Fedemayol024/Proyecto-Gen-Osc-STM32/hardware/ad9833_conexion.png

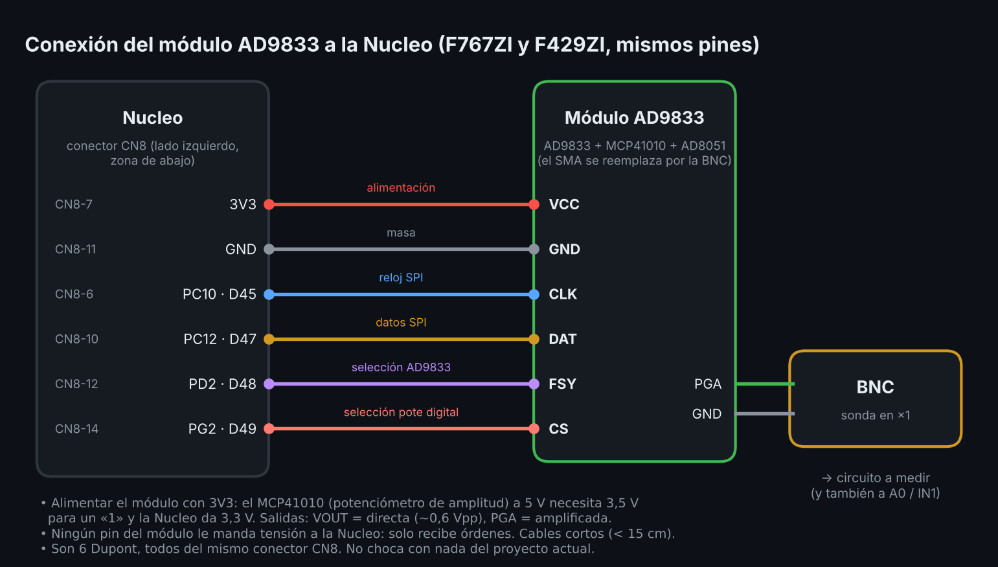
hardware/ad9833_conexion.png
