Fedemayol024/Proyecto-Gen-Osc-STM32/hardware/hoja1_salidas.png

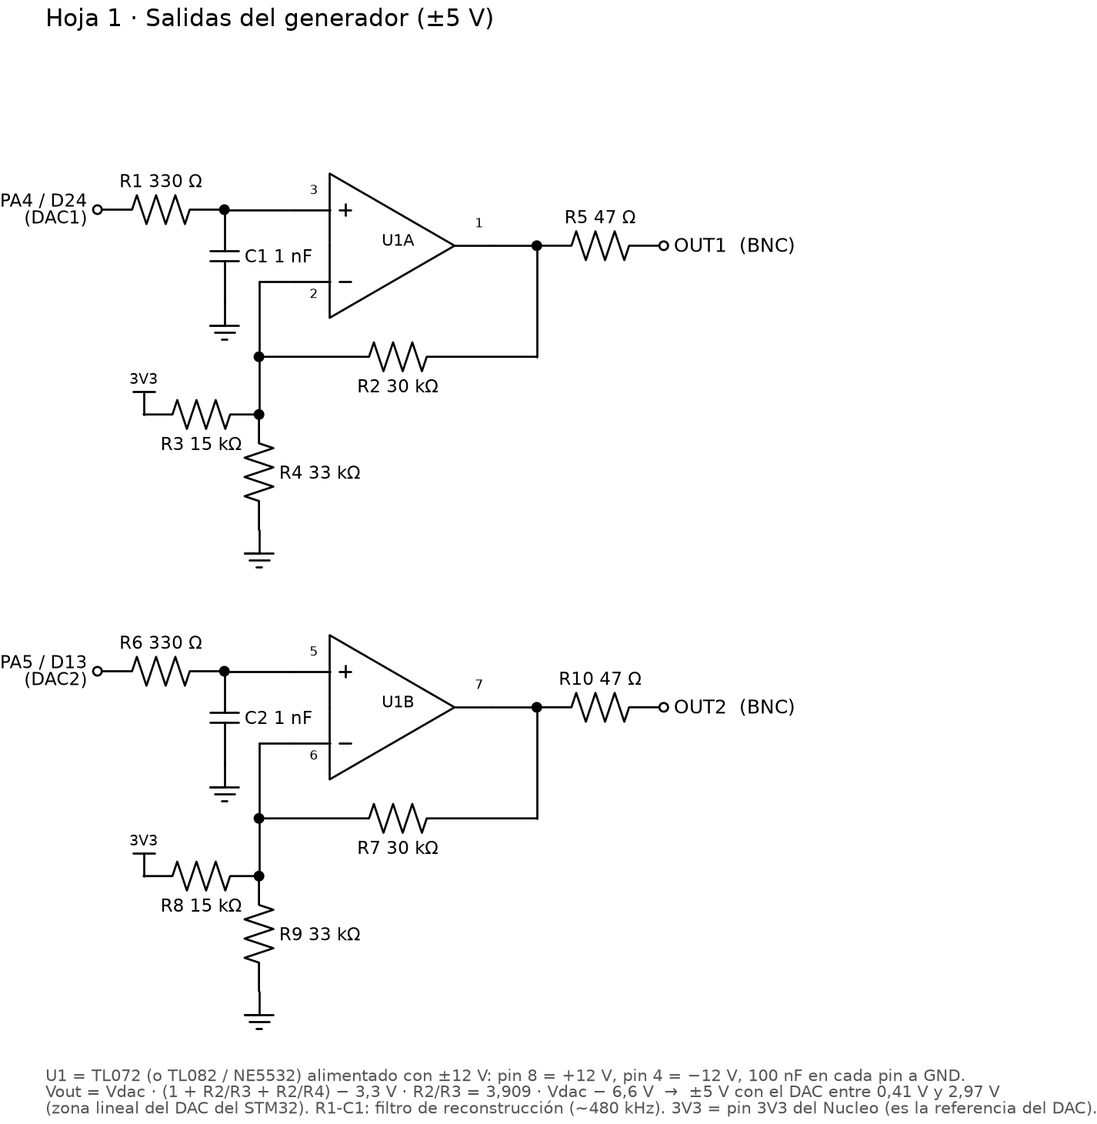
hardware/hoja1_salidas.png
