Fedemayol024/Proyecto-Gen-Osc-STM32/hardware/hoja2_entradas.png

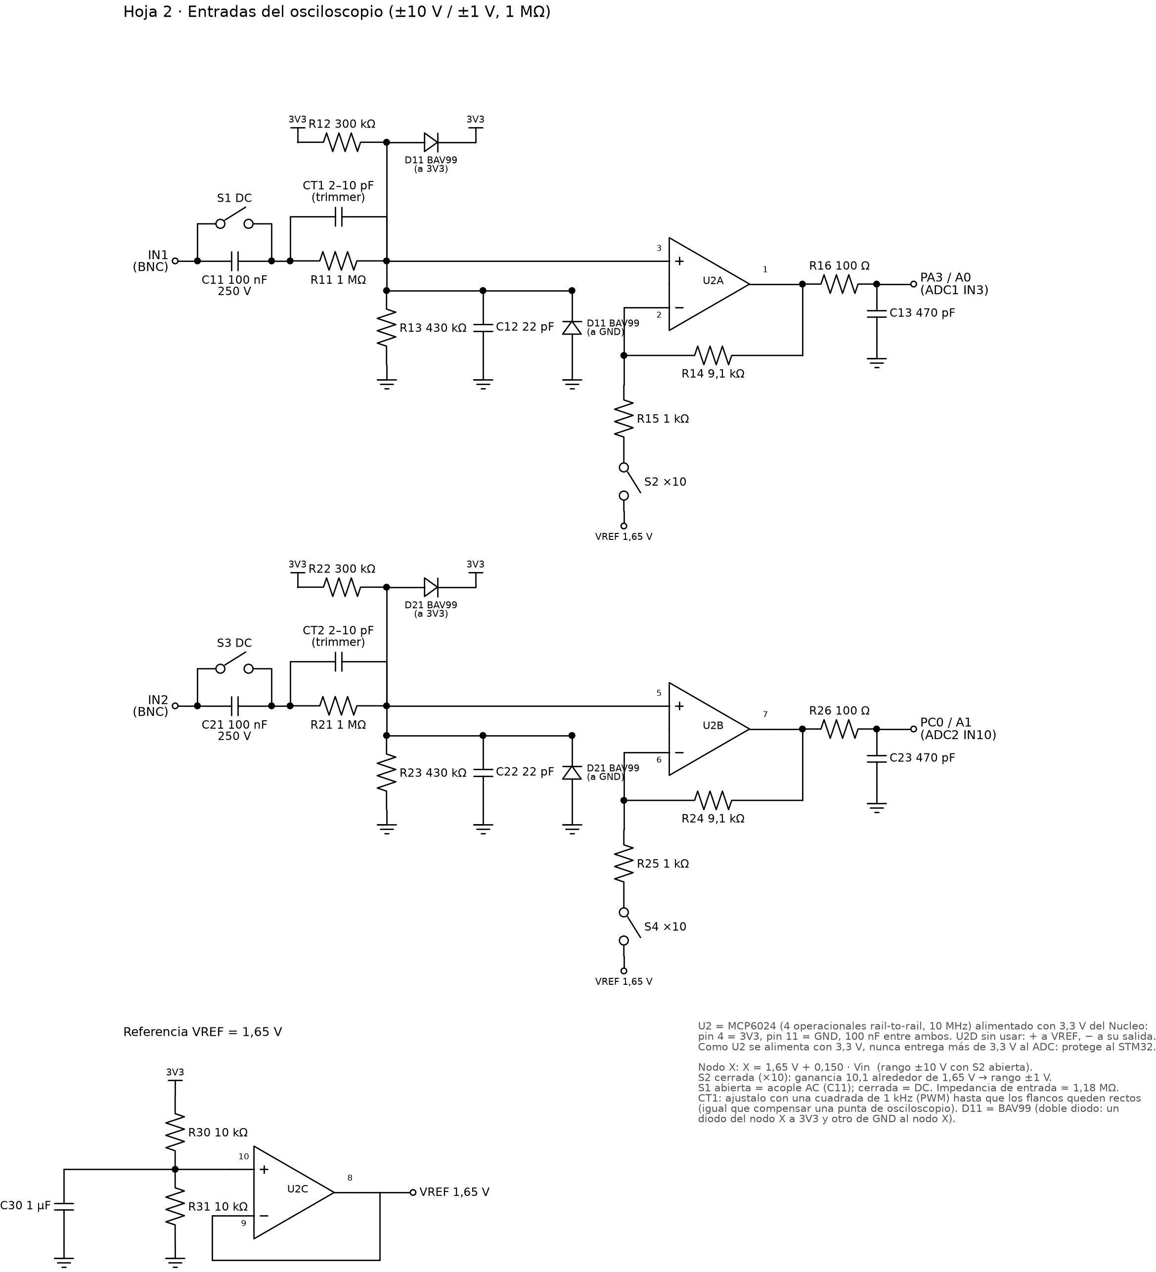
hardware/hoja2_entradas.png
