Fedemayol024/Proyecto-Gen-Osc-STM32/hardware/hoja3_frecuencimetro_pwm_alimentacion.png

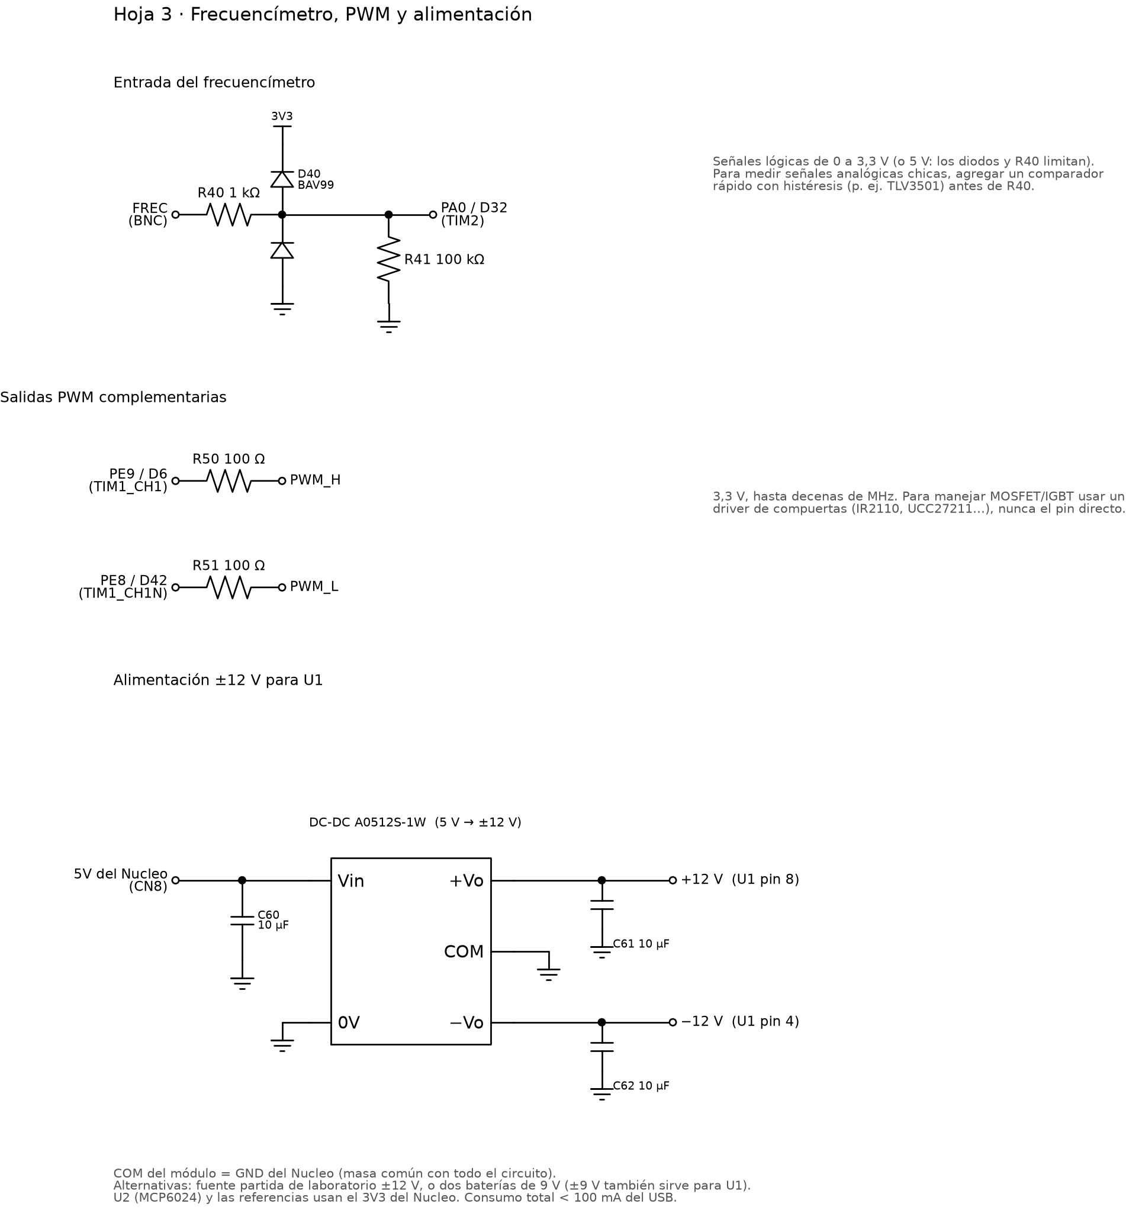
hardware/hoja3_frecuencimetro_pwm_alimentacion.png
