Fedemayol024/Proyecto-Gen-Osc-STM32/app/main.py

"""
Instrumento NUCLEO-F767ZI / NUCLEO-F429ZI - Osciloscopio + Generador + Bode + Herramientas
=========================================================================================
Al abrir se elige la placa (se puede recordar la elección y cambiarla después).
Ejecutar:   python main.py
Crear .exe: build_exe.bat
"""
from __future__ import annotations

import sys
import time
from pathlib import Path

from PySide6.QtCore import Qt, QTimer
from PySide6.QtGui import QActionGroup, QIcon
from PySide6.QtWidgets import (QApplication, QButtonGroup, QCheckBox, QComboBox, QDialog,
                               QHBoxLayout, QLabel, QMainWindow, QMenu, QMessageBox, QPushButton,
                               QStatusBar, QTabWidget, QToolButton, QVBoxLayout, QWidget)

import modelo as M
import widgets as W
from dispositivo import Dispositivo, listar_puertos
from tab_bode import TabBode
from tab_calibracion import TabCalibracion
from tab_generador import TabGenerador
from tab_herramientas import TabHerramientas
from tab_osciloscopio import TabOsciloscopio
from tab_placa import TabPlaca

# Versión de la app (MAYOR.MENOR.PARCHE). Mientras el MAYOR sea 0 es una beta: todavía
# se agregan funciones. El firmware usa el mismo número (INSTR_VERSION en instrumento.h);
# si cambia el MAYOR.MENOR, la app pide cargar el firmware nuevo.
VERSION = "0.9.0"
ETAPA = "beta"
VERSION_TEXTO = f"{VERSION} {ETAPA}".strip()


def misma_serie(a: str, b: str) -> bool:
    """True si dos versiones comparten MAYOR.MENOR (protocolo compatible)."""
    return a.split(".")[:2] == b.split(".")[:2]


def recurso(nombre: str) -> str:
    base = Path(getattr(sys, "_MEIPASS", Path(__file__).parent))
    return str(base / nombre)


class DialogoPlaca(QDialog):
    """Menú inicial: elegir con qué placa se va a trabajar."""

    def __init__(self, actual: str = M.PLACA_POR_DEFECTO, recordar: bool = False, parent=None):
        super().__init__(parent)
        self.setWindowTitle("Elegí la placa")
        W.tam(self, "setMinimumWidth", 520)
        lay = QVBoxLayout(self)
        lay.setContentsMargins(22, 20, 22, 18)
        lay.setSpacing(12)
        t = QLabel("¿Con qué placa vas a trabajar?")
        t.setStyleSheet(f"font-size: {W.pt(15)}pt; font-weight: 700; color: {W.TEXTO};")
        lay.addWidget(t)
        lay.addWidget(W.etiqueta_tenue("Cada placa tiene su propio firmware y guarda su propia "
                                       "calibración. Podés cambiarla después desde la barra de arriba."))
        self.grupo = QButtonGroup(self)
        self.grupo.setExclusive(True)
        self.botones = {}
        for clave, info in M.PLACAS.items():
            b = QPushButton(f"{info['nombre']}\n{info['detalle']}")
            b.setCheckable(True)
            W.tam(b, "setMinimumHeight", 64)
            b.setStyleSheet(f"QPushButton {{ text-align: left; padding: {W.px(10)}px {W.px(14)}px; font-size: {W.pt(11)}pt; }}")
            b.setChecked(clave == actual)
            b.clicked.connect(lambda _=False, c=clave: self._elegida(c))
            b.setProperty("clave", clave)
            self.grupo.addButton(b)
            self.botones[clave] = b
            lay.addWidget(b)
        self.recordar = QCheckBox("Recordar mi elección y no volver a preguntar")
        self.recordar.setChecked(recordar)
        lay.addWidget(self.recordar)
        fila = QHBoxLayout()
        fila.addStretch(1)
        fila.addWidget(W.boton("Cancelar", self.reject))
        self.btn_ok = W.boton("Continuar", self.accept, primario=True)
        fila.addWidget(self.btn_ok)
        lay.addLayout(fila)
        self._placa = actual if actual in M.PLACAS else M.PLACA_POR_DEFECTO
        self.botones[self._placa].setChecked(True)

    def _elegida(self, clave: str):
        self._placa = clave

    @property
    def placa(self) -> str:
        return self._placa


def elegir_placa(parent=None, forzar: bool = False) -> str | None:
    """Devuelve la placa elegida (y guarda la preferencia) o None si se canceló."""
    pref = M.cargar_preferencias()
    if not forzar and not pref["preguntar"]:
        return pref["placa"]
    dlg = DialogoPlaca(pref["placa"], recordar=not pref["preguntar"], parent=parent)
    if dlg.exec() != QDialog.Accepted:
        return None
    M.guardar_preferencias({"placa": dlg.placa, "preguntar": not dlg.recordar.isChecked()})
    return dlg.placa


class Ventana(QMainWindow):
    def __init__(self, placa: str = M.PLACA_POR_DEFECTO, auto_puerto: str | None = None):
        super().__init__()
        self.placa = placa if placa in M.PLACAS else M.PLACA_POR_DEFECTO
        self.version_app = VERSION_TEXTO
        nombre = M.nombre_placa(self.placa)
        self.setWindowTitle(f"Instrumento {nombre} · Osciloscopio y generador · v{VERSION_TEXTO}")
        self.resize(1360, 860)
        self.config = M.Config.cargar(self.placa)
        self.disp = Dispositivo()
        self.dueno_captura = None          # quién pidió la última captura
        self._esperado = None              # (n, pre) de la captura pedida
        self._mapa_puertos = {}

        central = QWidget()
        self.setCentralWidget(central)
        raiz = QVBoxLayout(central)
        raiz.setContentsMargins(8, 8, 8, 4)

        # barra de conexión
        barra = QHBoxLayout()
        titulo = QLabel("◉  Instrumento")
        titulo.setObjectName("titulo")
        barra.addWidget(titulo)
        self.btn_placa = W.boton(f"{nombre}  ▾", self._menu_placa)
        self.btn_placa.setToolTip("Cambiar de placa")
        barra.addWidget(self.btn_placa)
        barra.addSpacing(16)
        self.combo_puertos = QComboBox()
        W.tam(self.combo_puertos, "setMinimumWidth", 320)
        barra.addWidget(self.combo_puertos)
        barra.addWidget(W.boton("↻", self.actualizar_puertos))
        self.btn_con = W.boton("Conectar", self.alternar_conexion, primario=True)
        barra.addWidget(self.btn_con)
        # el texto de conexión es largo: se recorta con «…» si no entra (antes ensanchaba
        # la ventana más allá de la pantalla en las notebooks)
        self.lbl_con = W.EtiquetaRecortable("● Desconectado")
        self.lbl_con.setStyleSheet(f"color: {W.TENUE};")
        barra.addWidget(self.lbl_con, 1)
        # opciones gráficas (ruedita): resolución de la interfaz
        self.btn_opciones = QToolButton()
        self.btn_opciones.setText("⚙")
        self.btn_opciones.setObjectName("ruedita")
        self.btn_opciones.setToolTip("Opciones gráficas: resolución de la interfaz")
        self.btn_opciones.setPopupMode(QToolButton.InstantPopup)
        self.menu_opciones = QMenu(self)
        self.menu_opciones.aboutToShow.connect(self._armar_menu_opciones)
        self.btn_opciones.setMenu(self.menu_opciones)
        barra.addWidget(self.btn_opciones)
        raiz.addLayout(barra)
        W.al_cambiar_escala(self._escala_cambiada)

        self._t_guardar = QTimer(self)
        self._t_guardar.setSingleShot(True)
        self._t_guardar.timeout.connect(self.guardar_config)

        self.tabs = QTabWidget()
        raiz.addWidget(self.tabs, 1)
        self.tab_gen = TabGenerador(self)
        self.tab_osc = TabOsciloscopio(self)
        self.tab_bode = TabBode(self)
        self.tab_herr = TabHerramientas(self)
        self.tab_cal = TabCalibracion(self)
        self.tab_placa = TabPlaca(self)
        self.tabs.addTab(self.tab_osc, "Osciloscopio")
        self.tabs.addTab(self.tab_gen, "Generador")
        self.tabs.addTab(self.tab_bode, "Bode")
        self.tabs.addTab(self.tab_herr, "Frecuencímetro y PWM")
        self.tabs.addTab(self.tab_cal, "Calibración")
        self.tabs.addTab(self.tab_placa, "Placa")

        self.setStatusBar(QStatusBar())
        self.estado(f"Versión {VERSION_TEXTO}. Conectá el USB USER (CN13) del Nucleo y tocá Conectar.")
        self._escala_cambiada()

        self.disp.conectado.connect(self._al_conectar)
        self.disp.desconectado.connect(self._perdida_conexion)
        self.disp.error.connect(self._error_conexion)
        # Reconexión automática: si la placa se reinicia (watchdog, RESET, cable flojo) el puerto
        # USB desaparece y vuelve a aparecer; la app lo busca un rato y se reconecta sola.
        self._reconexion = None
        self._t_recon = QTimer(self)
        self._t_recon.timeout.connect(self._intentar_reconexion)
        self.disp.linea.connect(self._al_linea)
        self.disp.datos.connect(self._al_datos)

        self.actualizar_puertos()
        if auto_puerto:
            for et, dev in self._mapa_puertos.items():
                if dev == auto_puerto:
                    self.combo_puertos.setCurrentText(et)
                    QTimer.singleShot(400, self.alternar_conexion)
                    break

    # -------------------------------------------------------------- opciones gráficas
    def resolucion_pantalla(self) -> tuple[int, int]:
        """Resolución real (píxeles físicos) de la pantalla donde está la ventana."""
        pantalla = self.screen() or QApplication.primaryScreen()
        return resolucion_de(pantalla)

    def _armar_menu_opciones(self):
        m = self.menu_opciones
        m.clear()
        pant = self.resolucion_pantalla()
        elegida = M.resolucion_guardada()
        titulo = m.addAction("Resolución de la interfaz")
        titulo.setEnabled(False)
        grupo = QActionGroup(m)
        grupo.setExclusive(True)

        def opcion(texto, res):
            a = m.addAction(texto)
            a.setCheckable(True)
            a.setChecked(res == elegida)
            a.triggered.connect(lambda _=False, r=res: self.elegir_resolucion(r))
            grupo.addAction(a)
            return a

        opcion(f"Automática · la de la pantalla ({M.texto_resolucion(pant)})", None)
        m.addSeparator()
        for res in M.RESOLUCIONES:
            e = M.escala_para(res, pant)
            if not (M.ESCALA_MIN <= min(pant[0] / res[0], pant[1] / res[1]) <= M.ESCALA_MAX):
                continue
            if res == pant:
                nota = "igual a la pantalla"
            elif e > 1:
                nota = f"todo más grande · {round(e * 100)} %"
            else:
                nota = f"entra más · {round(e * 100)} %"
            opcion(f"{M.texto_resolucion(res)}   ({nota})", res)
        m.addSeparator()
        a = m.addAction("Ajustar la ventana a la pantalla")
        a.triggered.connect(lambda: self.ajustar_a_pantalla(forzar=True))

    def elegir_resolucion(self, res: tuple[int, int] | None):
        M.guardar_resolucion(res)
        escala = M.escala_para(res, self.resolucion_pantalla())
        if abs(escala - W.ESCALA) > 1e-6:
            QApplication.setOverrideCursor(Qt.WaitCursor)
            try:
                W.aplicar_escala(QApplication.instance(), escala)
            finally:
                QApplication.restoreOverrideCursor()
        self.ajustar_a_pantalla()
        QTimer.singleShot(0, self.ajustar_a_pantalla)     # por si el layout termina de crecer después
        nombre = M.texto_resolucion(res) if res else "automática (la de la pantalla)"
        self.estado(f"Resolución de la interfaz: {nombre} · escala {round(escala * 100)} %.", W.OK)

    def ajustar_a_pantalla(self, forzar: bool = False):
        """Que la ventana entre en la pantalla: si lo mínimo que necesita no entra, se
        maximiza (y se avisa); si sobra lugar, se respeta el tamaño que tenga."""
        if self.isFullScreen():
            return
        pantalla = self.screen() or QApplication.primaryScreen()
        libre = pantalla.availableGeometry()
        minimo = self.minimumSizeHint()
        if minimo.width() > libre.width() or minimo.height() > libre.height():
            self.showMaximized()
            self.estado("La interfaz no entra en esta pantalla: elegí una resolución más grande "
                        "en ⚙ (Opciones gráficas).", W.ALERTA)
            return
        if self.isMaximized() and not forzar:
            return
        ancho = min(max(self.width(), minimo.width()), libre.width())
        alto = min(max(self.height(), minimo.height()), libre.height())
        if forzar:
            self.showNormal()
            ancho, alto = libre.width(), libre.height()
        # El borde de la ventana (barra de título) suma al tamaño: se calcula con el
        # tamaño NUEVO, no con el que tenía antes de agrandarse.
        g = self.frameGeometry()
        borde_x, borde_y = g.width() - self.width(), g.height() - self.height()
        ancho = min(ancho, libre.width() - borde_x)
        alto = min(alto, libre.height() - borde_y)
        self.resize(ancho, alto)
        x = min(max(g.x(), libre.x()), libre.right() + 1 - (ancho + borde_x))
        y = min(max(g.y(), libre.y()), libre.bottom() + 1 - (alto + borde_y))
        self.move(max(x, libre.x()), max(y, libre.y()))

    def _escala_cambiada(self):
        W.escalar_graficos(self)
        for w in self.findChildren(QWidget):
            w.update()

    # -------------------------------------------------------------- placa
    def _menu_placa(self):
        nueva = elegir_placa(self, forzar=True)
        if nueva and nueva != self.placa:
            self.cambiar_placa(nueva)

    def cambiar_placa(self, placa: str, puerto: str | None = None):
        """Reabre la ventana con la configuración y calibración de otra placa."""
        pref = M.cargar_preferencias()
        pref["placa"] = placa
        M.guardar_preferencias(pref)
        if self.disp.esta_conectado:
            self.disp.enviar("CAPX")
            self.disp.cerrar()
        nueva = Ventana(placa, auto_puerto=puerto)
        nueva.resize(self.size())
        nueva.move(self.pos())
        app = QApplication.instance()
        app._ventana = nueva
        nueva.show()
        self.setAttribute(Qt.WA_DeleteOnClose)       # que la ventana vieja no quede viva
        self.close()

    # -------------------------------------------------------------- estado
    def estado(self, texto: str, color: str = W.TENUE):
        self.statusBar().setStyleSheet(f"color: {color};")
        self.statusBar().showMessage(texto)

    def guardar_config_pronto(self):
        self._t_guardar.start(1500)

    def guardar_config(self):
        if not hasattr(self, "tab_cal"):
            return
        self.config.gen = self.tab_gen.estado_config()
        self.config.osc = self.tab_osc.estado_config()
        h = self.tab_herr.estado_config()
        h["bode"] = self.tab_bode.estado_config()
        self.config.herramientas = h
        self.config.guardar()

    # -------------------------------------------------------------- conexión
    def actualizar_puertos(self):
        puertos = listar_puertos()
        self._mapa_puertos = {et: dev for dev, et in puertos}
        self.combo_puertos.clear()
        if not puertos:
            self.combo_puertos.addItem("No hay puertos")
            return
        self.combo_puertos.addItems([et for _, et in puertos])
        for dev, et in puertos:
            if dev == self.config.puerto:
                self.combo_puertos.setCurrentText(et)
                break

    # -------------------------------------------------------------- reconexión
    RECONEXION_S = 20.0

    def _perdida_conexion(self, motivo: str):
        puerto = self._reconexion["puerto"] if self._reconexion else self.config.puerto
        self._al_desconectar(f"{motivo} Reintentando conectar…", W.ALERTA)
        if puerto:
            self._reconexion = {"puerto": puerto, "hasta": time.monotonic() + self.RECONEXION_S,
                                "intentando": False}
            self.btn_con.setText("Cancelar")
            self.lbl_con.setText(f"● Reconectando con {puerto}…")
            self.lbl_con.setStyleSheet(f"color: {W.ALERTA};")
            self._t_recon.start(1000)

    def _error_conexion(self, motivo: str):
        if self._reconexion:                 # durante la reconexión los fallos son esperables
            self._reconexion["intentando"] = False
            return
        self._al_desconectar(motivo, W.ERROR)

    def _cancelar_reconexion(self):
        self._t_recon.stop()
        self._reconexion = None

    def _intentar_reconexion(self):
        r = self._reconexion
        if not r:
            self._t_recon.stop()
            return
        if self.disp.esta_conectado or r["intentando"]:
            return
        if time.monotonic() > r["hasta"]:
            self._cancelar_reconexion()
            self._al_desconectar("No se pudo reconectar con la placa. Revisá el cable USB USER y "
                                 "tocá Conectar.", W.ERROR)
            return
        if r["puerto"] in [dev for dev, _ in listar_puertos()]:
            r["intentando"] = True
            self.disp.abrir(r["puerto"])

    def alternar_conexion(self):
        if self._reconexion:                 # el botón dice «Cancelar»
            self._cancelar_reconexion()
            self.disp.cerrar()
            self._al_desconectar("Reconexión cancelada.", W.TENUE)
            return
        if self.disp.esta_conectado:
            self.disp.cerrar()
            self._al_desconectar("Desconectado.", W.TENUE)
            return
        puerto = self._mapa_puertos.get(self.combo_puertos.currentText())
        if not puerto:
            self.estado("Elegí un puerto (conectá el USB USER del Nucleo y tocá ↻).", W.ALERTA)
            return
        self.btn_con.setEnabled(False)
        self.btn_con.setText("Conectando…")
        self.lbl_con.setText(f"● Buscando el instrumento en {puerto}…")
        self.lbl_con.setStyleSheet(f"color: {W.ALERTA};")
        self.disp.abrir(puerto)

    def _al_conectar(self, version: str):
        detectada = self.disp.placa
        if detectada and detectada != self.placa:
            puerto = self.disp.puerto
            self.disp.cerrar()
            self._al_desconectar(f"La placa conectada es {M.nombre_placa(detectada)}, no "
                                 f"{M.nombre_placa(self.placa)}.", W.ALERTA)
            if detectada in M.PLACAS:
                r = QMessageBox.question(
                    self, "Otra placa",
                    f"La placa conectada es una {M.nombre_placa(detectada)}, pero la app está "
                    f"configurada para {M.nombre_placa(self.placa)}.\n\n"
                    f"¿Cambiar a {M.nombre_placa(detectada)} y conectar?")
                if r == QMessageBox.Yes:
                    self.cambiar_placa(detectada, puerto)
            return
        reconectado = self._reconexion is not None
        self._cancelar_reconexion()
        self.config.puerto = self.disp.puerto
        self.btn_con.setEnabled(True)
        self.btn_con.setText("Desconectar")
        info = self.disp.info
        self.lbl_con.setText(f"● Conectado · {self.disp.puerto} · {M.nombre_placa(self.placa)} · firmware v{version} · "
                             f"generador {M.si(info.get('gen_fs', 0), 'S/s', 3)} · "
                             f"osciloscopio hasta {M.si(info.get('osc_fsmax', 0), 'S/s', 3)}")
        self.lbl_con.setStyleSheet(f"color: {W.OK};")
        self.tab_gen.reenviar_todo()
        self.tab_osc.al_conectar()
        self.tab_placa.al_conectar()
        self.guardar_config_pronto()
        if not misma_serie(version, VERSION):
            self.estado(f"El firmware de la placa es v{version} y la app es v{VERSION}: cargá el "
                        "firmware de esta versión para que todo funcione bien.", W.ALERTA)
        elif info.get("reinicio") == "watchdog":
            self.estado("Atención: la placa se reinició sola porque el firmware se había colgado "
                        "(watchdog). Se volvió a enviar la configuración.", W.ALERTA)
        elif reconectado:
            self.estado("Reconectado automáticamente. Se volvió a enviar la configuración.", W.OK)
        else:
            self.estado("Instrumento conectado.", W.OK)

    def _al_desconectar(self, motivo: str, color: str):
        self.btn_con.setEnabled(True)
        self.btn_con.setText("Conectar")
        self.lbl_con.setText("● Desconectado")
        self.lbl_con.setStyleSheet(f"color: {W.TENUE};")
        self.tab_osc.al_desconectar()
        self.tab_herr.al_desconectar()
        self.tab_placa.al_desconectar()
        if self.tab_bode.activo:
            self.tab_bode.activo = False
            self.tab_bode.btn.setText("Iniciar barrido")
        self.estado(motivo, color)

    def _al_linea(self, linea: str):
        if linea.startswith("ERR") and not linea.startswith("ERR GTBL"):
            self.estado(f"La placa respondió: {linea}", W.ERROR)
        self.tab_gen.al_linea(linea)
        self.tab_herr.al_linea(linea)

    def pedir_captura(self, dueno: str, n: int, pre: int, fs: float, fuente: int = 0,
                      nivel: int = 2048, flanco: int = 0, hist: int = 20):
        """Pide una captura y recuerda quién la pidió (los datos que no
        coinciden con el último pedido se descartan)."""
        self.dueno_captura = dueno
        self._esperado = (int(n), int(pre))
        self.disp.enviar(f"CAP {int(n)} {int(pre)} {fs:.4f} {fuente} {nivel} {flanco} {hist}")

    def cancelar_captura(self):
        self._esperado = None
        if self.disp.esta_conectado:
            self.disp.enviar("CAPX")

    def _al_datos(self, d: dict):
        if self._esperado is None or (d["n"], d["pre"]) != self._esperado:
            return
        self._esperado = None
        dueno = self.dueno_captura
        if dueno == "bode":
            self.tab_bode.al_recibir(d)
        elif dueno == "cal":
            self.tab_cal.al_recibir(d)
        elif dueno == "dds":
            self.tab_gen.dds.al_captura(d)
        else:
            self.tab_osc.al_recibir(d)

    def closeEvent(self, e):
        self.tab_osc.fosforo.timer.stop()
        if self.tab_osc.dlg_fft is not None:
            self.tab_osc.dlg_fft.close()
        self.guardar_config()
        if self.disp.esta_conectado:
            self.disp.enviar("CAPX")
        self.disp.cerrar()
        super().closeEvent(e)


def resolucion_de(pantalla) -> tuple[int, int]:
    """Píxeles físicos de una pantalla (Qt da medidas lógicas, ya divididas por el
    escalado de Windows: 1920×1080 al 150 % aparece como 1280×720)."""
    if pantalla is None:
        return (1920, 1080)
    g, r = pantalla.geometry(), pantalla.devicePixelRatio()
    return (round(g.width() * r), round(g.height() * r))


def main():
    app = QApplication(sys.argv)
    W.ESCALA = M.escala_para(M.resolucion_guardada(), resolucion_de(app.primaryScreen()))
    app.setStyleSheet(W.estilo())
    ico = recurso("icono.ico")
    if Path(ico).exists():
        app.setWindowIcon(QIcon(ico))
    placa = elegir_placa()
    if placa is None:
        return
    app._ventana = Ventana(placa)
    app._ventana.show()
    QTimer.singleShot(0, app._ventana.ajustar_a_pantalla)
    sys.exit(app.exec())


if __name__ == "__main__":
    main()
