Fedemayol024/Proyecto-Gen-Osc-STM32/app/modelo.py

"""
Modelo del instrumento: calibraciones, conversión tensión <-> código y
armado de las tablas de forma de onda. No depende de la interfaz.
"""
from __future__ import annotations

import json
import math
import os
from dataclasses import dataclass, asdict, field
from pathlib import Path

import numpy as np

TABLA_N = 4096           # puntos por período en el generador
DAC_MAX = 4095
ADC_MAX = 4095
VREF = 3.3


# ---------------------------------------------------------------------------
# Recta código <-> tensión (sirve para el DAC y para el ADC)
# ---------------------------------------------------------------------------
@dataclass
class Recta:
    codigo_a: float
    volt_a: float
    codigo_b: float
    volt_b: float

    @property
    def pendiente(self) -> float:
        return (self.volt_b - self.volt_a) / (self.codigo_b - self.codigo_a)

    def volt(self, codigo):
        return self.volt_a + (np.asarray(codigo, dtype=float) - self.codigo_a) * self.pendiente

    def codigo(self, volt):
        return self.codigo_a + (np.asarray(volt, dtype=float) - self.volt_a) / self.pendiente

    def valida(self) -> bool:
        try:
            return (self.codigo_a != self.codigo_b and abs(self.pendiente) > 1e-9
                    and all(math.isfinite(v) for v in asdict(self).values()))
        except (ZeroDivisionError, TypeError):
            return False

    @staticmethod
    def desde_dict(d) -> "Recta | None":
        try:
            r = Recta(float(d["codigo_a"]), float(d["volt_a"]), float(d["codigo_b"]), float(d["volt_b"]))
            return r if r.valida() else None
        except (KeyError, TypeError, ValueError):
            return None


def _recta_lineal(f, c0=0.0, c1=4095.0) -> Recta:
    return Recta(c0, float(f(c0)), c1, float(f(c1)))


# ---------------------------------------------------------------------------
# Salidas del generador
# ---------------------------------------------------------------------------
# Etapa de salida de la placa (igual topología que el proyecto ESP32):
#   Vout = Vdac (1 + Rf/Rref + Rf/Rgnd) - 3,3 V · Rf/Rref
RF_OUT, RREF_OUT, RGND_OUT = 30e3, 15e3, 33e3
G_OUT = 1 + RF_OUT / RREF_OUT + RF_OUT / RGND_OUT
OFF_OUT = VREF * RF_OUT / RREF_OUT

# Zona lineal del DAC del STM32 con el buffer de salida activado
DAC_V_MIN, DAC_V_MAX = 0.2, 3.1


@dataclass(frozen=True)
class ModoSalida:
    clave: str
    nombre: str
    vmin: float
    vmax: float
    diseno: Recta


def _vdac(c):
    return VREF * np.asarray(c, dtype=float) / DAC_MAX


MODOS_SALIDA = {
    "PLACA": ModoSalida("PLACA", "Placa ±5 V", -5.0, 5.0,
                        _recta_lineal(lambda c: G_OUT * _vdac(c) - OFF_OUT)),
    "DIRECTO": ModoSalida("DIRECTO", "Pin directo (0,2–3,1 V)", DAC_V_MIN, DAC_V_MAX,
                          _recta_lineal(_vdac)),
}

# ---------------------------------------------------------------------------
# Entradas del osciloscopio
# ---------------------------------------------------------------------------
# Atenuador de entrada: X = 1,65 V + K·Vin   (R1 = 1 MΩ, R2 = 300 kΩ a 3,3 V,
# R3 = 430 kΩ a GND) y luego ganancia 1 o 10,1 alrededor de 1,65 V.
R1_IN, R2_IN, R3_IN = 1e6, 300e3, 430e3
_G = 1 / R1_IN + 1 / R2_IN + 1 / R3_IN
K_IN = (1 / R1_IN) / _G
BIAS_IN = (VREF / R2_IN) / _G
G_ALTA = 1 + 9.1e3 / 1e3
VMED = 1.65


def _vadc(c):
    return VREF * np.asarray(c, dtype=float) / ADC_MAX


@dataclass(frozen=True)
class ModoEntrada:
    clave: str
    nombre: str
    rango: float          # ± tensión de entrada aproximada (para la interfaz)
    diseno: Recta


def _vin_rango(ganancia):
    # Vadc = VMED + g·(BIAS_IN + K·Vin - VMED)  ->  Vin
    return lambda c: ((_vadc(c) - VMED) / ganancia + VMED - BIAS_IN) / K_IN


MODOS_ENTRADA = {
    "ALTO": ModoEntrada("ALTO", "Placa ±10 V", 10.0, _recta_lineal(_vin_rango(1.0))),
    "BAJO": ModoEntrada("BAJO", "Placa ±1 V (×10)", 1.0, _recta_lineal(_vin_rango(G_ALTA))),
    "DIRECTO": ModoEntrada("DIRECTO", "Pin directo (0–3,3 V)", 3.3, _recta_lineal(_vadc)),
}

# ---------------------------------------------------------------------------
# Formas de onda
# ---------------------------------------------------------------------------
FORMAS = ["Senoidal", "Cuadrada", "Triangular", "Diente de sierra", "Continua", "Ruido", "Arbitraria"]


def forma_normalizada(forma: str, ciclo: float, arbitraria: np.ndarray | None = None) -> np.ndarray:
    """Un período de la forma, valores entre -1 y 1 (Continua devuelve 0)."""
    x = np.arange(TABLA_N) / TABLA_N
    d = min(max(ciclo / 100.0, 0.0), 1.0)
    if forma == "Senoidal":
        return np.sin(2 * np.pi * x)
    if forma == "Cuadrada":
        return np.where(x < d, 1.0, -1.0)
    if forma == "Triangular":
        if d <= 0:
            y = 1 - x
        elif d >= 1:
            y = x
        else:
            y = np.where(x < d, x / d, (1 - x) / (1 - d))
        return 2 * y - 1
    if forma == "Diente de sierra":
        return 2 * x - 1
    if forma == "Ruido":
        rng = np.random.default_rng(12345)
        r = rng.standard_normal(TABLA_N)
        return np.clip(r / 3.0, -1, 1)          # ±3 sigma ocupan la amplitud
    if forma == "Arbitraria" and arbitraria is not None and len(arbitraria) >= 2:
        a = np.asarray(arbitraria, dtype=float)
        xp = np.arange(len(a)) / len(a)
        y = np.interp(x, xp, a, period=1.0)
        lo, hi = y.min(), y.max()
        return (2 * (y - lo) / (hi - lo) - 1) if hi > lo else np.zeros(TABLA_N)
    return np.zeros(TABLA_N)


def num_csv(x: float, fmt: str = ".6g") -> str:
    """Número para un CSV separado por ';' con coma decimal, como lo abre Excel en español."""
    return format(x, fmt).replace(".", ",")


def leer_csv_forma(ruta: str) -> np.ndarray:
    """Lee una columna de números (la última de cada fila) de un CSV o TXT.
    Acepta ';' o tabulador con coma o punto decimal, y ',' con punto decimal."""
    valores = []
    with open(ruta, encoding="utf-8", errors="replace") as f:
        for linea in f:
            sep = ";" if ";" in linea else "\t" if "\t" in linea else ","
            partes = [p for p in linea.split(sep) if p.strip()]
            if not partes:
                continue
            try:
                valores.append(float(partes[-1].strip().replace(" ", "").replace(",", ".")))
            except ValueError:
                continue
    if len(valores) < 2:
        raise ValueError("El archivo no tiene al menos 2 valores numéricos.")
    return np.array(valores)


@dataclass
class CanalGen:
    habilitado: bool = True
    forma: str = "Senoidal"
    frecuencia: float = 1000.0
    vpp: float = 2.0
    offset: float = 0.0
    ciclo: float = 50.0
    fase: float = 0.0
    modulacion: str = "Ninguna"        # Ninguna / AM / FM
    mod_frec: float = 10.0
    am_prof: float = 50.0              # %
    fm_desvio: float = 100.0           # Hz
    barrido: str = "No"                # No / Lineal / Logarítmico
    bar_f1: float = 100.0
    bar_f2: float = 10_000.0
    bar_t: float = 1.0
    modo_salida: str = "PLACA"


@dataclass
class TablaGen:
    codigos: np.ndarray          # uint16, TABLA_N
    volts: np.ndarray            # lo que sale de verdad (simulado)
    recortada: bool
    lim: tuple[float, float]
    reposo: int                  # código para 0 V (o el mínimo)
    centro: float                # código del offset (para AM)


def limites_salida(modo: ModoSalida, cal: Recta) -> tuple[float, float]:
    """Rango utilizable: zona lineal del DAC ∩ límites de la salida."""
    c_lo = DAC_V_MIN / VREF * DAC_MAX
    c_hi = DAC_V_MAX / VREF * DAC_MAX
    v1, v2 = float(cal.volt(c_lo)), float(cal.volt(c_hi))
    lo, hi = min(v1, v2), max(v1, v2)
    return max(lo, modo.vmin), min(hi, modo.vmax)


def armar_tabla(c: CanalGen, cal: Recta, arbitraria: np.ndarray | None = None) -> TablaGen:
    modo = MODOS_SALIDA[c.modo_salida]
    lo, hi = limites_salida(modo, cal)
    norm = forma_normalizada(c.forma, c.ciclo, arbitraria)
    if c.forma == "Continua":
        v = np.full(TABLA_N, c.offset)
    else:
        v = c.offset + norm * c.vpp / 2.0
    paso = abs(cal.pendiente)
    recortada = bool(v.min() < lo - paso or v.max() > hi + paso)
    v = np.clip(v, lo, hi)
    cod = np.clip(np.rint(cal.codigo(v)), 0, DAC_MAX).astype(np.uint16)
    v_real = cal.volt(cod)
    cero = min(max(0.0, lo), hi)
    reposo = int(np.clip(np.rint(cal.codigo(cero)), 0, DAC_MAX))
    centro = float(np.clip(cal.codigo(min(max(c.offset, lo), hi)), 0, DAC_MAX))
    return TablaGen(cod, v_real, recortada, (lo, hi), reposo, centro)


# ---------------------------------------------------------------------------
# Mediciones sobre una señal muestreada
# ---------------------------------------------------------------------------
def medir(v: np.ndarray, fs: float) -> dict:
    if v is None or len(v) < 4:
        return {}
    vmax, vmin = float(v.max()), float(v.min())
    media = float(v.mean())
    rms = float(np.sqrt(np.mean(v * v)))
    vpp = vmax - vmin
    r = {"vmax": vmax, "vmin": vmin, "vpp": vpp, "media": media, "rms": rms,
         "frec": None, "periodo": None, "ciclo": None}
    if vpp <= 0:
        return r
    h = 0.1 * vpp
    alto = media + h / 2
    bajo = media - h / 2
    estado = v[0] > media
    subidas = []
    for i in range(1, len(v)):
        if not estado and v[i] > alto:
            estado = True
            # interpolación lineal del cruce por la media
            j = i
            while j > 0 and v[j - 1] > media:
                j -= 1
            if j > 0 and v[j] != v[j - 1]:
                subidas.append(j - 1 + (media - v[j - 1]) / (v[j] - v[j - 1]))
            else:
                subidas.append(float(j))
        elif estado and v[i] < bajo:
            estado = False
    if len(subidas) >= 2 and fs > 0:
        periodo_m = (subidas[-1] - subidas[0]) / (len(subidas) - 1)
        if periodo_m > 0:
            r["periodo"] = periodo_m / fs
            r["frec"] = fs / periodo_m
            a, b = int(subidas[0]), int(subidas[-1])
            if b > a:
                r["ciclo"] = 100.0 * float(np.mean(v[a:b] > media))
    return r


def suavizar(v: np.ndarray, ventana: int) -> np.ndarray:
    """Promedio móvil centrado de 'ventana' puntos. Los bordes se rellenan
    repitiendo el primer y el último valor: con ceros (np.convolve 'same'), los
    extremos de la captura caían hacia 0 V."""
    if ventana <= 1 or len(v) < ventana:
        return v
    izq = ventana // 2
    relleno = np.pad(v, (izq, ventana - 1 - izq), mode="edge")
    return np.convolve(relleno, np.ones(ventana) / ventana, mode="valid")


def fasor_seno(v: np.ndarray, fs: float, f: float) -> tuple[complex, float]:
    """Ajuste por mínimos cuadrados a A·sen(2πft + φ) + C.
    Devuelve (A·e^jφ, residuo eficaz del ajuste)."""
    t = np.arange(len(v)) / fs
    w = 2 * np.pi * f * t
    m = np.column_stack([np.sin(w), np.cos(w), np.ones_like(w)])
    coef, *_ = np.linalg.lstsq(m, v, rcond=None)
    residuo = float(np.sqrt(np.mean((v - m @ coef) ** 2)))
    return complex(coef[0], coef[1]), residuo


# ---------------------------------------------------------------------------
# Bode: largo de cada captura y promedio de las que hagan falta
# ---------------------------------------------------------------------------
# El ruido de la amplitud y la fase ajustadas baja con la raíz del número de muestras, así
# que conviene la captura más larga posible sin que el barrido se haga eterno.
BODE_T_CAPTURA = 0.2       # s de captura buscados por punto (al menos 8 períodos)
BODE_T_PUNTO = 2.0         # s máximos por punto sumando las repeticiones
BODE_FASE_OBJ = math.radians(1.0)
BODE_REP_MAX = 16


def captura_bode(f: float, fs_max: float, ventana: int = 8192,
                 t_obj: float = BODE_T_CAPTURA) -> tuple[int, float]:
    """(n, fs) de la captura para un punto del barrido: al menos 50 muestras por período
    y 8 períodos, y la ventana completa siempre que no tarde más de 't_obj'."""
    t = max(8.0 / f, t_obj)
    fs = min(fs_max, max(50.0 * f, ventana / t))
    n = int(min(ventana, max(400, round(t * fs))))
    return n, fs


def repeticiones_bode(amp: float, residuo: float, n: int, t_captura: float,
                      fase_obj: float = BODE_FASE_OBJ, maximo: int = BODE_REP_MAX,
                      t_punto: float = BODE_T_PUNTO) -> int:
    """Capturas a promediar para que la incertidumbre de la fase quede en 'fase_obj'.
    Con ruido blanco de valor eficaz 'residuo', la del ajuste es residuo·√(2/n)/amp."""
    incert = residuo * math.sqrt(2.0 / max(n, 1)) / max(amp, 1e-12)
    k = math.ceil((incert / fase_obj) ** 2)
    tope = max(1, int(t_punto // max(t_captura, 1e-9)))
    return int(min(maximo, tope, max(1, k)))


# ---------------------------------------------------------------------------
# Bode con una fuente externa (AD9833): submuestreo y frecuencia estimada de los datos
# ---------------------------------------------------------------------------
# Arriba de ~fs/2,5 el ADC no puede seguir la señal, pero muestreándola a una fs elegida
# aparece «plegada» en f_alias = f − k·fs. Como CH1 y CH2 se muestrean en el mismo instante,
# el cociente salida/entrada del alias conserva la ganancia y la fase reales del circuito.
# El AD9833 tiene su propio reloj (no está sincronizado con el de la placa): por eso la
# frecuencia se estima de los datos de CH1 en vez de suponerla exacta.
BODE_DIRECTO_MAX = 1 / 2.5          # hasta fs_max/2,5 se mide directo (≥ 2,5 muestras/período)
BODE_ALIAS_OBJ = 0.25               # el alias se ubica cerca de fs/4 (lejos de 0 y de fs/2)
BODE_DDS_FMAX = 10e6


def alias(f: float, fs: float) -> float:
    """Frecuencia aparente (con signo) de una senoidal de f muestreada a fs: en (−fs/2, fs/2].
    Negativa = el espectro llega «dado vuelta» (la fase medida sale con el signo cambiado)."""
    a = f - round(f / fs) * fs
    if a <= -fs / 2:
        a += fs
    return a


def fs_submuestreo(f: float, fs_max: float, fs_min: float | None = None,
                   candidatos: int = 600) -> float:
    """fs (≤ fs_max) para que el alias de f quede cerca de fs/4: lejos de 0 (no se puede
    separar de la continua) y de fs/2 (ahí el signo de la fase es ambiguo)."""
    fs_min = fs_min or fs_max * 0.5
    mejor, puntaje = fs_max, 1e9
    for fs in np.linspace(fs_max, fs_min, candidatos):
        r = abs(alias(f, fs)) / fs
        p = abs(r - BODE_ALIAS_OBJ) + 0.02 * (1 - fs / fs_max)      # preferir fs alta
        if p < puntaje:
            mejor, puntaje = float(fs), p
    return mejor


def estimar_frecuencia(v: np.ndarray, fs: float, f_aprox: float, bins: float = 4.0) -> float:
    """Frecuencia de la senoidal de v cerca de f_aprox (≥ 0): pico de la FFT con ventana de
    Hann e interpolación, y después el máximo de la amplitud del ajuste senoidal."""
    v = np.asarray(v, dtype=float)
    n = len(v)
    if n < 16:
        return f_aprox
    espectro = np.abs(np.fft.rfft((v - v.mean()) * np.hanning(n)))
    df = fs / n
    k0 = f_aprox / df
    lo, hi = max(1, int(math.floor(k0 - bins))), min(len(espectro) - 2, int(math.ceil(k0 + bins)))
    if hi <= lo:
        return f_aprox
    k = lo + int(np.argmax(espectro[lo:hi + 1]))
    a, b, c = np.log(espectro[k - 1:k + 2] + 1e-30)
    den = a - 2 * b + c
    delta = 0.5 * (a - c) / den if den < 0 else 0.0
    f = (k + max(-0.5, min(0.5, delta))) * df

    def amplitud(x):
        return abs(fasor_seno(v, fs, x)[0])

    izq, der = f - 0.6 * df, f + 0.6 * df                  # sección áurea sobre ±0,6 bin
    g = (math.sqrt(5) - 1) / 2
    x1, x2 = der - g * (der - izq), izq + g * (der - izq)
    a1, a2 = amplitud(x1), amplitud(x2)
    for _ in range(18):
        if a1 > a2:
            der, x2, a2 = x2, x1, a1
            x1 = der - g * (der - izq)
            a1 = amplitud(x1)
        else:
            izq, x1, a1 = x1, x2, a2
            x2 = izq + g * (der - izq)
            a2 = amplitud(x2)
    return (izq + der) / 2


def respuesta_bode(v1: np.ndarray, v2: np.ndarray, fs: float, f: float,
                   estimar: bool = True) -> tuple[complex, float, float, float]:
    """H = salida/entrada a la frecuencia f (real, aunque esté por encima de Nyquist).
    Devuelve (H, amplitud de entrada, amplitud de salida, residuo del ajuste de salida).
    Con 'estimar', la frecuencia aparente se ajusta a los datos de CH1."""
    a = alias(f, fs)
    fa = abs(a)
    if estimar:
        fa = estimar_frecuencia(v1, fs, fa)
    x1, _ = fasor_seno(v1, fs, fa)
    x2, r2 = fasor_seno(v2, fs, fa)
    if abs(x1) < 1e-12:
        return 0j, 0.0, abs(x2), r2
    h = x2 / x1
    if a < 0:                       # alias dado vuelta: la fase sale con el signo cambiado
        h = h.conjugate()
    return h, abs(x1), abs(x2), r2


def captura_bode_dds(f: float, fs_max: float, ventana: int = 8192) -> tuple[int, float, bool]:
    """(n, fs, submuestreo) para medir f con el AD9833."""
    if f <= fs_max * BODE_DIRECTO_MAX:
        n, fs = captura_bode(f, fs_max, ventana)
        return n, fs, False
    return ventana, fs_submuestreo(f, fs_max), True


# ---------------------------------------------------------------------------
# Bode: ajuste de un modelo (polos y ceros) a la curva medida
# ---------------------------------------------------------------------------
# Se ajusta H(s) = N(s)/D(s) de orden 1 y 2 (Sanathanan–Koerner: mínimos cuadrados lineales
# iterados) con pesos robustos: los puntos que no encajan (autorresonancias lejanas, acople)
# pesan poco y no arruinan el ajuste. Se elige el más simple que explique la curva y se
# describe en palabras: tipo de respuesta, polos, ceros, Q y −3 dB desde la meseta correcta.
BODE_ORDENES = [(0, 1), (1, 1), (0, 2), (1, 2), (2, 2), (2, 1), (3, 2), (2, 3), (3, 3)]     # (grado numerador, grado denominador)


@dataclass
class ModeloBode:
    num: np.ndarray                  # coeficientes en s/ω0, de menor a mayor grado
    den: np.ndarray                  # den[0] = 1
    w0: float                        # escala de frecuencia (rad/s)
    orden: tuple
    error_db: float                  # error eficaz (dB) en los puntos usados
    error_fase: float                # error eficaz (°)
    usados: np.ndarray = field(default_factory=lambda: np.array([], dtype=bool))

    def h(self, f) -> np.ndarray:
        x = 1j * 2 * np.pi * np.asarray(f, dtype=float) / self.w0
        return np.polyval(self.num[::-1], x) / np.polyval(self.den[::-1], x)

    def raices(self, coef) -> np.ndarray:
        c = np.trim_zeros(np.asarray(coef[::-1], dtype=float), "f")
        return np.roots(c) * self.w0 if len(c) > 1 else np.array([])

    @property
    def polos(self) -> np.ndarray:
        return self.raices(self.den)

    @property
    def ceros(self) -> np.ndarray:
        return self.raices(self.num)


def _resolver(x, H, n, d, w):
    """Una iteración de Sanathanan–Koerner: N(x) − H·D(x) = 0, pesado por w."""
    cols = [(x ** i) for i in range(n + 1)] + [(-H * x ** i) for i in range(1, d + 1)]
    A = np.column_stack(cols) * w[:, None]
    b = H * w
    Ar = np.vstack([A.real, A.imag])
    br = np.concatenate([b.real, b.imag])
    sol, *_ = np.linalg.lstsq(Ar, br, rcond=None)
    return sol[:n + 1], np.concatenate([[1.0], sol[n + 1:]])


def ajustar_bode(f, H, n, d, iter_sk=12, iter_robusto=6) -> ModeloBode | None:
    f = np.asarray(f, dtype=float)
    H = np.asarray(H, dtype=complex)
    w0 = 2 * np.pi * math.sqrt(f.min() * f.max())
    x = 1j * 2 * np.pi * f / w0
    peso = np.ones(len(f))
    den = np.ones(1)
    num = None
    for _ in range(iter_robusto):
        den = np.ones(1)
        for _ in range(iter_sk):
            dprev = np.polyval(den[::-1], x)
            w = peso / np.abs(H * dprev)           # error relativo (como en dB y grados)
            num, den = _resolver(x, H, n, d, w)
        hm = np.polyval(num[::-1], x) / np.polyval(den[::-1], x)
        e = np.abs(np.log(hm / H))                 # |Δln| ~ dB/8,7 y fase en rad juntos
        escala = max(1.5 * np.median(e), 0.06, np.quantile(e, 0.8))
        peso = 1 / (1 + (e / escala) ** 2)         # los puntos que no encajan pesan poco
    # Un polo muy por encima del rango casi no se nota en la medición: el ruido decide de qué
    # lado del plano cae. Si cae del lado inestable se lo refleja (mismo módulo en jω, la fase
    # cambia apenas) en vez de tirar un modelo que ajusta bien.
    rx = np.roots(den[::-1]) if len(den) > 1 else np.array([])
    lejos = (rx.real > 0) & (np.abs(rx) * w0 / (2 * np.pi) > 5 * f.max())
    if lejos.any():
        rx = np.where(lejos, -np.conj(rx), rx)
        den = np.real(np.poly(rx)[::-1])
        den = den / den[0]
    hm = np.polyval(num[::-1], x) / np.polyval(den[::-1], x)
    usados = peso > 0.5
    if usados.sum() < max(4, n + d + 2):
        return None
    edb = 20 * np.log10(np.abs(hm[usados] / H[usados]))
    efa = np.degrees(np.angle(hm[usados] / H[usados]))
    m = ModeloBode(num, den, w0, (n, d), float(np.sqrt(np.mean(edb ** 2))),
                   float(np.sqrt(np.mean(efa ** 2))), usados)
    if np.any(m.polos.real > 1e-9 * w0):           # inestable: no describe un circuito pasivo
        return None
    return m


def mejor_modelo_bode(f, H) -> ModeloBode | None:
    candidatos = []
    for n, d in BODE_ORDENES:
        try:
            m = ajustar_bode(f, H, n, d)
        except (np.linalg.LinAlgError, ValueError):
            m = None
        if m is None:
            continue
        frac = m.usados.mean()
        puntaje = m.error_db + m.error_fase / 10 + 0.15 * (n + d) + 3 * (1 - frac)
        candidatos.append((puntaje, m))
    if not candidatos:
        return None
    return min(candidatos, key=lambda c: c[0])[1]


def _db_abs(x):
    return 20 * np.log10(np.maximum(np.abs(x), 1e-15))


def _fmt_hz(hz):
    for div, u in ((1e6, "MHz"), (1e3, "kHz"), (1, "Hz")):
        if hz >= div:
            return f"{hz / div:.3g} {u}".replace(".", ",")
    return f"{hz:.3g} Hz".replace(".", ",")


def analizar_modelo_bode(m: ModeloBode, f) -> dict:
    """Describe el modelo: tipo de respuesta, polos y ceros que importan y frecuencias de −3 dB
    medidas desde la meseta que corresponde (no desde un máximo suelto)."""
    f = np.asarray(f, dtype=float)
    fmin, fmax = f.min(), f.max()
    fg = np.logspace(np.log10(fmin), np.log10(fmax), 800)
    g = _db_abs(m.h(fg))
    gmax = g.max()

    def grupos(raices):
        """[(frecuencia, Q | None)] juntando los pares complejos."""
        out, vistos = [], []
        for r in raices:
            if any(abs(r - np.conj(v)) < 1e-6 * max(abs(r), 1) for v in vistos):
                continue
            vistos.append(r)
            fr = abs(r) / (2 * np.pi)
            q = abs(r) / (2 * abs(r.real)) if abs(r.imag) > 1e-3 * abs(r) and abs(r.real) > 0 else None
            out.append((fr, q))
        return out

    polos, ceros = grupos(m.polos), grupos(m.ceros)
    # Ceros reales donde la curva ya está 40 dB abajo del máximo: es el piso de acople entre
    # canales (o el ruido), no el circuito.
    piso = None
    ceros_circ = []
    for fz, q in ceros:
        # el nivel se mira un poco antes del cero (justo en un rechazo la curva se hunde)
        if fmin <= fz <= fmax * 3 and _db_abs(m.h([fz / 2]))[0] < gmax - 37:
            piso = fz if piso is None else min(piso, fz)
        else:
            ceros_circ.append((fz, q))
    en_rango = lambda fr: fmin / 1.5 <= fr <= fmax * 1.5          # noqa: E731
    p_in = [p for p in polos if en_rango(p[0])]
    z_in = [z for z in ceros_circ if en_rango(z[0])]
    z_bajos = sum(1 for z in ceros_circ if z[0] < fmin / 1.5)   # ceros «en 0»: pendiente de subida
    # Modelo «del circuito»: sin las singularidades de más arriba del rango ni el piso de acople
    def h_circ(x):
        s = 1j * 2 * np.pi * np.asarray(x, dtype=float)
        h = m.h(x)
        for r in m.polos:
            if abs(r) / (2 * np.pi) > fmax * 1.5:
                h = h * (1 - s / r)
        for r in m.ceros:
            fr = abs(r) / (2 * np.pi)
            if fr > fmax * 1.5 or (piso is not None and abs(fr - piso) < 1e-6 * fr):
                h = h / (1 - s / r)
        return h
    gc = _db_abs(h_circ(fg))
    g_lo, g_hi, k_pk = gc[0], gc[-1], int(np.argmax(gc))
    g_pk = gc[k_pk]

    def cruces(ref):
        nivel = ref - 3
        out = []
        for i in range(1, len(fg)):
            a, b = gc[i - 1] - nivel, gc[i] - nivel
            if a * b < 0:
                x = math.log10(fg[i - 1]) + (math.log10(fg[i]) - math.log10(fg[i - 1])) * a / (a - b)
                out.append(10 ** x)
        return out

    # Mesetas: tramos donde la curva casi no cambia (< 4 dB/década) a lo largo de ≥ 0,25
    # décadas. Sirven para medir el corte desde la meseta y no desde una subida de más arriba
    # (autorresonancia, capacidades del protoboard) que el modelo también tiene que seguir.
    lf = np.log10(fg)
    plano = np.abs(np.gradient(gc, lf)) < 4
    mesetas, i = [], 0
    while i < len(fg):
        if plano[i]:
            j = i
            while j + 1 < len(fg) and plano[j + 1]:
                j += 1
            if lf[j] - lf[i] >= 0.25:
                mesetas.append((fg[i], fg[j], float(np.median(gc[i:j + 1]))))
            i = j + 1
        else:
            i += 1

    complejos = [p for p in p_in if p[1] is not None]
    detalles, f3, ref = [], [], None
    if g_pk - max(g_lo, g_hi) > 3 and 0 < k_pk < len(fg) - 1:
        tipo = "Pasabanda / resonancia"
        ref = g_pk
        f3 = cruces(g_pk)
        detalles.append(f"Pico de {g_pk:.2f} dB en {_fmt_hz(fg[k_pk])}".replace(".", ",", 1))
        if len(f3) >= 2:
            detalles.append(f"Ancho de banda (−3 dB): {_fmt_hz(f3[0])} a {_fmt_hz(f3[-1])}")
    elif g_lo - g_hi > 6:
        orden = "2º orden" if complejos or len(p_in) >= 2 else "1er orden"
        reales = [z for z in z_in if z[1] is None]
        tipo = f"Pasabajos de {orden}" if not reales else "Pasabajos con escalón"
        ref = g_lo
        f3 = cruces(g_lo)[:1]
    elif g_hi - g_lo > 6:
        if [z for z in z_in if z[1] is None] and not z_bajos:
            tipo = "Pasaaltos con pérdida en continua (escalón)"
        else:
            tipo = "Pasaaltos de 2º orden" if (complejos or z_bajos >= 2) else "Pasaaltos de 1er orden"
        ref, hasta = g_hi, fmax
        altas = [mz for mz in mesetas if mz[2] > g_lo + 6]
        if altas:                                   # la primera meseta de arriba de la subida
            ref, hasta = altas[0][2], altas[0][0]
        f3 = [x for x in cruces(ref) if x <= hasta * 1.001][-1:] or cruces(ref)[-1:]
    else:
        tipo = "Respuesta casi plana"
    for fr, q in p_in:
        detalles.append(f"Polo en {_fmt_hz(fr)}" + (f" (Q = {q:.2f})".replace(".", ",") if q else ""))
    for fr, q in z_in:
        detalles.append(("Rechazo / autorresonancia en " if q else "Cero en ") + _fmt_hz(fr)
                        + (f" (Q = {q:.2f})".replace(".", ",") if q else ""))
    if g_lo > -200:
        detalles.append(f"Ganancia en baja frecuencia: {g_lo:.2f} dB".replace(".", ","))
    if piso is not None:
        detalles.append(f"Arriba de ~{_fmt_hz(piso)} domina un piso de {_db_abs(m.h([fmax * 10]))[0]:.0f} dB "
                        "(acople entre CH1 y CH2): ahí la medición no es del circuito")
    return {"tipo": tipo, "f3db": f3, "ref_db": ref, "detalles": detalles, "piso": piso,
            "error_db": m.error_db, "error_fase": m.error_fase, "orden": m.orden}


def singularidades_bode(m: ModeloBode, f, analisis: dict | None = None) -> list[dict]:
    """Polos y ceros del modelo, uno por fila (los pares complejos juntos), ordenados por
    frecuencia: clase, frecuencia (Hz), Q (pares complejos), raíz s (rad/s; la de parte
    imaginaria ≥ 0), región respecto del rango medido y si es el piso de acople."""
    f = np.asarray(f, dtype=float)
    fmin, fmax = f.min(), f.max()
    piso = (analisis or {}).get("piso")
    filas = []
    for clase, raices in (("polo", m.polos), ("cero", m.ceros)):
        vistos = []
        for r in raices:
            if any(abs(r - np.conj(v)) < 1e-6 * max(abs(r), 1) for v in vistos):
                continue
            vistos.append(r)
            fr = abs(r) / (2 * np.pi)
            par = abs(r.imag) > 1e-3 * abs(r) and abs(r.real) > 0
            q = abs(r) / (2 * abs(r.real)) if par else None
            if fr < fmin / 1.5:
                region = "abajo del rango (≈ 0)"
            elif fr > fmax * 1.5:
                region = "arriba del rango"
            else:
                region = "en el rango"
            filas.append({"clase": clase, "f": fr, "q": q, "par": par,
                          "s": complex(r.real, abs(r.imag)), "region": region,
                          "piso": clase == "cero" and piso is not None and abs(fr - piso) < 1e-6 * fr})
    filas.sort(key=lambda x: x["f"])
    return filas


def ganancia_continua_bode(m: ModeloBode) -> complex:
    """H(0) del modelo (K en H(s) = K·Π(1 − s/zᵢ)/Π(1 − s/pᵢ))."""
    return complex(m.num[0] / m.den[0])


# ---------------------------------------------------------------------------
# Espectro (FFT): ventanas, promediado, piso de ruido y picos
# ---------------------------------------------------------------------------
VENTANAS = ["Hann", "Hamming", "Blackman-Harris", "Flat-top", "Rectangular"]
DB_MIN = -160.0          # piso de la escala en dB (nada se dibuja más abajo)


def ventana_fft(nombre: str, n: int) -> np.ndarray:
    k = np.arange(n) / max(n - 1, 1) * 2 * np.pi
    if nombre == "Hamming":
        return 0.54 - 0.46 * np.cos(k)
    if nombre == "Blackman-Harris":
        return 0.35875 - 0.48829 * np.cos(k) + 0.14128 * np.cos(2 * k) - 0.01168 * np.cos(3 * k)
    if nombre == "Flat-top":
        return (0.21557895 - 0.41663158 * np.cos(k) + 0.277263158 * np.cos(2 * k)
                - 0.083578947 * np.cos(3 * k) + 0.006947368 * np.cos(4 * k))
    if nombre == "Rectangular":
        return np.ones(n)
    return np.hanning(n)


def enbw(w: np.ndarray) -> float:
    """Ancho de banda equivalente de ruido de la ventana, en bins."""
    return float(len(w) * np.sum(w ** 2) / np.sum(w) ** 2)


def espectro_potencia(v: np.ndarray, fs: float, ventana: str = "Hann") -> tuple[np.ndarray, np.ndarray, float]:
    """Frecuencias, potencia de cada bin (V² eficaces de una senoidal centrada en ese bin)
    y ENBW de la ventana (bins). Una senoidal de A V eficaces da A² en su bin."""
    v = np.asarray(v, dtype=float)
    n = len(v)
    w = ventana_fft(ventana, n)
    x = np.fft.rfft((v - v.mean()) * w)
    p = 2 * np.abs(x) ** 2 / np.sum(w) ** 2
    p[0] = v.mean() ** 2
    return np.fft.rfftfreq(n, 1 / fs), p, enbw(w)


def a_db(p: np.ndarray) -> np.ndarray:
    return 10 * np.log10(np.maximum(p, 10 ** (DB_MIN / 10)))


def espectro(v: np.ndarray, fs: float, ventana: str = "Hann") -> tuple[np.ndarray, np.ndarray]:
    """Espectro en dBV (valor eficaz de cada componente)."""
    f, p, _ = espectro_potencia(v, fs, ventana)
    return f, a_db(p)


def piso_ruido(p: np.ndarray, promedios: int = 1, ancho: int | None = None) -> np.ndarray:
    """Estimación del piso de ruido (potencia media por bin) con una mediana móvil, que no
    se deja llevar por los picos. La mediana del ruido blanco queda por debajo de su media
    (ln 2 sin promediar, casi 1 con muchos promedios) y se corrige."""
    p = np.asarray(p, dtype=float)
    n = len(p)
    if n < 8:
        return np.full(n, float(np.median(p)) if n else 0.0)
    if ancho is None:
        ancho = int(np.clip(n // 48, 9, 151))
    ancho |= 1
    m = ancho // 2
    ext = np.concatenate([p[1:m + 1][::-1], p, p[-m - 1:-1][::-1]])
    med = np.median(np.lib.stride_tricks.sliding_window_view(ext, ancho), axis=1)
    k = max(1, int(promedios))
    corr = math.log(2) if k == 1 else max(math.log(2), 1 - 1 / (3 * k))
    return med / corr


def quitar_piso(p: np.ndarray, piso: np.ndarray, fuerza: float = 2.0, resto: float = 1e-4) -> np.ndarray:
    """Sustracción espectral: resta el piso de ruido (con un factor de sobre-resta) y deja
    un resto muy chico donde solo había ruido. Las componentes reales casi no cambian."""
    return np.maximum(p - fuerza * piso, resto * piso)


def _interp_parabolica(db: np.ndarray, i: int) -> tuple[float, float]:
    """Corrección de posición (en bins) y nivel del pico por ajuste de una parábola."""
    if i <= 0 or i >= len(db) - 1:
        return 0.0, float(db[i])
    a, b, c = db[i - 1], db[i], db[i + 1]
    den = a - 2 * b + c
    if den >= 0:
        return 0.0, float(b)
    d = 0.5 * (a - c) / den
    d = float(np.clip(d, -0.5, 0.5))
    return d, float(b - 0.25 * (a - c) * d)


def _centroide(p: np.ndarray, k: int, medio: int) -> float:
    """Corrección (en bins) de la frecuencia de un pico por el centro de masa de su lóbulo.
    Funciona con cualquier ventana, también con la flat-top (que tiene el pico plano)."""
    a, b = max(0, k - medio), min(len(p), k + medio + 1)
    w = p[a:b]
    s = float(np.sum(w))
    if s <= 0:
        return 0.0
    return float(np.sum(w * np.arange(a, b)) / s) - k


def medio_lobulo(enbw_bins: float) -> int:
    """Medio ancho (bins) del lóbulo principal, aproximado a partir del ENBW."""
    return max(1, int(round(1.6 * enbw_bins)))


def buscar_picos(f: np.ndarray, p: np.ndarray, piso: np.ndarray, umbral_db: float = -80.0,
                 sobre_piso_db: float = 10.0, sep_hz: float = 0.0, max_picos: int = 10,
                 ignorar_dc: bool = True, enbw_bins: float = 1.5) -> list[dict]:
    """Picos del espectro (potencia p) que superan el umbral absoluto y quedan al menos
    `sobre_piso_db` por encima del piso de ruido. Ordenados de mayor a menor nivel."""
    db = a_db(p)
    db_piso = a_db(piso)
    n = len(db)
    if n < 3:
        return []
    df = float(f[1] - f[0]) if n > 1 else 1.0
    i = np.arange(1, n - 1)
    loc = (db[i] > db[i - 1]) & (db[i] >= db[i + 1])
    cand = i[loc]
    if ignorar_dc:
        cand = cand[cand >= 3]
    cand = cand[(db[cand] >= umbral_db) & (db[cand] - db_piso[cand] >= sobre_piso_db)]
    cand = cand[np.argsort(db[cand])[::-1]]
    medio = medio_lobulo(enbw_bins)
    sep = max(sep_hz, (medio + 1) * df)
    elegidos: list[dict] = []
    for k in cand:
        a, b = max(0, k - medio), min(n, k + medio + 1)
        pot = float(np.sum(p[a:b] - piso[a:b])) / enbw_bins      # Parseval: no depende del bin
        nivel = 10 * math.log10(pot) if pot > p[k] * 0.5 else float(db[k])
        fk = float(f[k] + _centroide(p, int(k), medio) * df)
        if any(abs(fk - e["f"]) < sep for e in elegidos):
            continue
        elegidos.append({"f": fk, "db": nivel, "bin": int(k), "sobre_piso": float(db[k] - db_piso[k])})
        if len(elegidos) >= max_picos:
            break
    return elegidos


def _zona(p: np.ndarray, piso: np.ndarray, k: int, medio: int, tope: int | None = None) -> tuple[int, int]:
    """Bins que ocupa una componente: su lóbulo principal más las «polleras» de la ventana
    mientras sigan claramente por encima del piso de ruido."""
    n = len(p)
    tope = max(medio, n // 16 if tope is None else tope)
    a, b = max(0, k - medio), min(n, k + medio + 1)
    while a > 0 and k - a < tope and p[a - 1] > 2 * piso[a - 1]:
        a -= 1
    while b < n and b - k < tope and p[b] > 2 * piso[b]:
        b += 1
    return a, b


def analizar_armonicos(f: np.ndarray, p: np.ndarray, piso: np.ndarray, enbw_bins: float,
                       f0: float | None = None, n_arm: int = 10) -> dict | None:
    """Fundamental, armónicos, THD, SNR, SINAD y ENOB a partir de la potencia por bin.
    La potencia de una componente es la suma de su zona dividida por el ENBW (menos el ruido
    que cae en esa zona). El ruido es todo lo demás, y bajo las zonas se estima con el piso."""
    n = len(p)
    if n < 16:
        return None
    df = float(f[1] - f[0])
    medio = medio_lobulo(enbw_bins) + 1
    if f0 is None:
        k0 = int(np.argmax(p[3:])) + 3
    else:
        k0 = int(round(f0 / df))
        if not 3 <= k0 < n:
            return None
        a, b = max(3, k0 - 2), min(n, k0 + 3)
        k0 = a + int(np.argmax(p[a:b]))
    f_fund = float(f[k0] + _centroide(p, k0, medio - 1) * df)
    tope = max(medio, int(0.45 * f_fund / df))           # una zona no invade la del armónico vecino
    usados = np.zeros(n, bool)
    a, b = _zona(p, piso, 0, medio, tope)
    usados[:b] = True                                           # continua

    def potencia(a, b):
        return max(float(np.sum(p[a:b]) - np.sum(piso[a:b])) / enbw_bins, 0.0)

    a, b = _zona(p, piso, k0, medio, tope)
    p_fund = potencia(a, b)
    usados[a:b] = True
    armonicos = []
    for h in range(2, n_arm + 1):
        kh = int(round(h * f_fund / df))
        if kh >= n - 1:
            break
        a, b = max(0, kh - 2), min(n, kh + 3)
        kh = a + int(np.argmax(p[a:b]))
        a, b = _zona(p, piso, kh, medio, tope)
        armonicos.append({"n": h, "f": float(f[kh]), "p": potencia(a, b)})
        usados[a:b] = True
    p_arm = sum(x["p"] for x in armonicos)
    p_ruido = float(np.sum(p[~usados]) + np.sum(piso[usados])) / enbw_bins
    if p_fund <= 0:
        return None
    thd = math.sqrt(p_arm / p_fund)
    snr = 10 * math.log10(p_fund / max(p_ruido, 1e-30))
    sinad = 10 * math.log10(p_fund / max(p_ruido + p_arm, 1e-30))
    piso_med = float(np.median(piso[3:]))
    return {"f0": f_fund, "a0": math.sqrt(p_fund), "thd": thd,
            "thd_db": 20 * math.log10(max(thd, 1e-12)), "snr": snr, "sinad": sinad,
            "enob": (sinad - 1.76) / 6.02, "armonicos": armonicos,
            "piso_db": 10 * math.log10(max(piso_med, 1e-30)),
            "densidad": math.sqrt(max(piso_med, 0.0) / (enbw_bins * df)),
            "rbw": enbw_bins * df,
            # con pocos períodos en pantalla los armónicos caen dentro del lóbulo del fundamental
            "resolucion_ok": f_fund / df >= 3 * medio}


class PromedioEspectro:
    """Promedio de potencias de los últimos N cuadros (promedio exponencial equivalente).
    Promediar potencias no baja el piso, pero lo vuelve parejo: desaparecen los
    «micropicos» del ruido blanco y las componentes reales quedan quietas."""

    def __init__(self):
        self.clave = None
        self.p = None
        self.cuenta = 0

    def reiniciar(self):
        self.clave, self.p, self.cuenta = None, None, 0

    def agregar(self, clave, p: np.ndarray, n: int) -> np.ndarray:
        if n <= 1:
            self.reiniciar()
            return p
        if clave != self.clave or self.p is None or len(self.p) != len(p):
            self.clave, self.p, self.cuenta = clave, p.copy(), 1
            return self.p
        self.cuenta += 1
        a = 1.0 / min(self.cuenta, n)
        self.p = self.p + a * (p - self.p)
        return self.p

    @property
    def efectivos(self) -> int:
        return max(1, self.cuenta)


# ---------------------------------------------------------------------------
# Persistencia (fósforo): un trazo pasado a una grilla de puntos de pantalla
# ---------------------------------------------------------------------------
def rasterizar_trazo(x: np.ndarray, y: np.ndarray, cols: int, filas: int,
                     x_max: float, y_min: float, y_max: float) -> np.ndarray:
    """Marca en una grilla (cols × filas, índice [col, fila], fila 0 abajo) los puntos por
    donde pasa el trazo, uniendo cada muestra con la siguiente para que los flancos y los
    picos angostos queden marcados aunque caigan entre dos muestras."""
    img = np.zeros((cols, filas), dtype=bool)
    x = np.asarray(x, dtype=float)
    y = np.asarray(y, dtype=float)
    if len(x) < 2:
        return img
    if len(x) < 2 * cols:                          # pocas muestras: interpolar para no dejar huecos
        xs = np.linspace(x[0], x[-1], 2 * cols)
        y = np.interp(xs, x, y)
        x = xs
    cx = np.floor(x / x_max * cols).astype(np.int64)
    fy = (y - y_min) / (y_max - y_min) * filas
    a, b = fy[:-1], fy[1:]
    cx = cx[:-1]
    ok = (cx >= 0) & (cx < cols) & ~((a < 0) & (b < 0)) & ~((a >= filas) & (b >= filas))
    lo = np.clip(np.floor(np.minimum(a, b)), 0, filas - 1).astype(np.int64)[ok]
    hi = np.clip(np.floor(np.maximum(a, b)), 0, filas - 1).astype(np.int64)[ok]
    cx = cx[ok]
    if not len(cx):
        return img
    largo = hi - lo + 1
    total = int(largo.sum())
    inicio = np.repeat(np.cumsum(largo) - largo, largo)
    filas_idx = np.repeat(lo, largo) + (np.arange(total) - inicio)
    img[np.repeat(cx, largo), filas_idx] = True
    return img


# ---------------------------------------------------------------------------
# Formato de números (coma decimal)
# ---------------------------------------------------------------------------
_PREF = [(1e9, "G"), (1e6, "M"), (1e3, "k"), (1.0, ""), (1e-3, "m"), (1e-6, "µ"), (1e-9, "n")]
_SUF = {"G": 1e9, "M": 1e6, "k": 1e3, "K": 1e3, "m": 1e-3, "u": 1e-6, "µ": 1e-6, "n": 1e-9}


def si(valor, unidad: str = "", cifras: int = 4) -> str:
    if valor is None or not math.isfinite(valor):
        return "—"
    if valor == 0:
        return f"0 {unidad}".strip()
    a = abs(valor)
    for fac, p in _PREF:
        if a >= fac * (1 - 1e-12):
            break
    num = valor / fac
    dec = max(0, cifras - 1 - int(math.floor(math.log10(abs(num)))))
    t = f"{num:.{dec}f}"
    if "." in t:
        t = t.rstrip("0").rstrip(".")
    return f"{t.replace('.', ',').replace('-', '−')} {p}{unidad}".strip()


def leer_si(texto: str) -> float:
    t = texto.strip().replace(" ", "").replace(",", ".").replace("−", "-")
    for u in ("Hz", "hz", "V", "v", "s", "%", "°", "dB"):
        if t.endswith(u) and len(t) > len(u):
            t = t[: -len(u)]
            break
    mult = 1.0
    if t and t[-1] in _SUF:
        mult = _SUF[t[-1]]
        t = t[:-1]
    v = float(t) * mult
    if not math.isfinite(v):
        raise ValueError
    return v


# ---------------------------------------------------------------------------
# Configuración persistente
# ---------------------------------------------------------------------------
# ---------------------------------------------------------------------------
# Placas soportadas
# ---------------------------------------------------------------------------
# Clave = lo que responde el firmware a "ID?" ("INSTR-F767 v0.8.19" -> "F767").
PLACAS = {
    "F767": {"nombre": "NUCLEO-F767ZI",
             "detalle": "Cortex-M7 · 216 MHz · osciloscopio hasta ~1,6 MS/s"},
    "F429": {"nombre": "NUCLEO-F429ZI",
             "detalle": "Cortex-M4 · 168 MHz · osciloscopio hasta ~1,2 MS/s"},
}
PLACA_POR_DEFECTO = "F767"


def nombre_placa(placa: str) -> str:
    return PLACAS.get(placa, {}).get("nombre", f"placa {placa}")


def carpeta_config() -> Path:
    base = os.environ.get("APPDATA")
    # Se mantiene el nombre de carpeta original para no perder calibraciones.
    return Path(base) / "InstrumentoF767" if base else Path.home() / ".instrumento_f767"


def ruta_config(placa: str = PLACA_POR_DEFECTO) -> Path:
    """Cada placa tiene su propia configuración (las calibraciones dependen del
    DAC y del ADC de cada micro). La F767 conserva el nombre original."""
    nombre = "config.json" if placa == PLACA_POR_DEFECTO else f"config_{placa}.json"
    return carpeta_config() / nombre


# ---------------------------------------------------------------------------
# Módulo AD9833 (DDS externo, con potenciómetro digital MCP41010 para la amplitud)
# ---------------------------------------------------------------------------
DDS_MCLK = 25e6                       # oscilador nominal del módulo
DDS_MCLK_MIN, DDS_MCLK_MAX = 20e6, 30e6
DDS_F_MIN, DDS_F_MAX = 0.1, 12.5e6
DDS_FORMAS = ["Seno", "Triangular", "Cuadrada", "Cuadrada f/2"]
DDS_MODULACIONES = ["Ninguna", "Barrido", "FSK", "PSK", "Ráfaga", "AM"]
DDS_TASA_MAX = 5000.0                 # FSK / PSK: símbolos por segundo
DDS_AM_FMAX = 200.0
# Puntos sugeridos para calibrar la amplitud (% del potenciómetro)
DDS_PUNTOS_CAL = [0.0, 25.0, 50.0, 75.0, 100.0]


def _num(v, defecto: float, vmin: float, vmax: float) -> float:
    try:
        x = float(v)
    except (TypeError, ValueError):
        return defecto
    if not math.isfinite(x):
        return defecto
    return min(max(x, vmin), vmax)


@dataclass
class ConfigDDS:
    habilitado: bool = False
    forma: str = "Seno"
    frecuencia: float = 100e3
    amplitud: float = 50.0            # % del potenciómetro digital (0..100)
    fase: float = 0.0                 # grados
    modulacion: str = "Ninguna"
    bar_log: bool = True
    bar_f1: float = 1e3
    bar_f2: float = 1e6
    bar_t: float = 2.0
    fsk_f2: float = 2e3
    fsk_tasa: float = 100.0
    psk_fase2: float = 180.0
    psk_tasa: float = 100.0
    raf_ciclos: float = 10.0
    raf_periodo: float = 0.01
    am_prof: float = 50.0             # %
    am_frec: float = 10.0
    mclk: float = DDS_MCLK            # reloj real del módulo (se mide con el frecuencímetro)
    cal: list = field(default_factory=list)   # [[%, Vpp, V media | None], ...] medidos

    @staticmethod
    def desde_dict(d: dict | None) -> "ConfigDDS":
        c = ConfigDDS()
        d = d if isinstance(d, dict) else {}
        c.habilitado = bool(d.get("habilitado", False))
        c.forma = d.get("forma") if d.get("forma") in DDS_FORMAS else "Seno"
        c.modulacion = d.get("modulacion") if d.get("modulacion") in DDS_MODULACIONES else "Ninguna"
        c.bar_log = bool(d.get("bar_log", True))
        mclk = _num(d.get("mclk"), DDS_MCLK, 0.0, 1e12)
        c.mclk = mclk if DDS_MCLK_MIN <= mclk <= DDS_MCLK_MAX else DDS_MCLK   # igual que el firmware
        fmax = c.mclk / 2
        c.frecuencia = _num(d.get("frecuencia"), 100e3, DDS_F_MIN, fmax)
        c.amplitud = _num(d.get("amplitud"), 50.0, 0.0, 100.0)
        c.fase = _num(d.get("fase"), 0.0, 0.0, 360.0)
        c.bar_f1 = _num(d.get("bar_f1"), 1e3, DDS_F_MIN, fmax)
        c.bar_f2 = _num(d.get("bar_f2"), 1e6, DDS_F_MIN, fmax)
        c.bar_t = _num(d.get("bar_t"), 2.0, 0.05, 1000.0)
        c.fsk_f2 = _num(d.get("fsk_f2"), 2e3, 0.0, fmax)
        c.fsk_tasa = _num(d.get("fsk_tasa"), 100.0, 0.1, DDS_TASA_MAX)
        c.psk_fase2 = _num(d.get("psk_fase2"), 180.0, 0.0, 360.0)
        c.psk_tasa = _num(d.get("psk_tasa"), 100.0, 0.1, DDS_TASA_MAX)
        c.raf_ciclos = float(round(_num(d.get("raf_ciclos"), 10.0, 1.0, 1e6)))
        c.raf_periodo = _num(d.get("raf_periodo"), 0.01, 0.001, 100.0)
        c.am_prof = _num(d.get("am_prof"), 50.0, 0.0, 100.0)
        c.am_frec = _num(d.get("am_frec"), 10.0, 0.01, DDS_AM_FMAX)
        c.cal = limpiar_cal_dds(d.get("cal"))
        return c


def limpiar_cal_dds(cal) -> list:
    """Puntos de calibración válidos, ordenados por %: [[%, Vpp, V media o None], ...]."""
    salida = {}
    if isinstance(cal, (list, tuple)):
        for fila in cal:
            try:
                pct, vpp = float(fila[0]), float(fila[1])
                vmed = float(fila[2]) if len(fila) > 2 and fila[2] is not None else None
            except (TypeError, ValueError, IndexError):
                continue
            if 0 <= pct <= 100 and 0 <= vpp < 100 and math.isfinite(vpp):
                salida[pct] = [pct, vpp, vmed if vmed is None or math.isfinite(vmed) else None]
    return [salida[k] for k in sorted(salida)]


def dds_frecuencia_real(f: float, mclk: float = DDS_MCLK) -> float:
    """El AD9833 tiene 28 bits de frecuencia: paso de mclk / 2^28 (≈ 0,093 Hz)."""
    f = min(max(f, 0.0), mclk / 2)             # igual que el firmware
    reg = min(round(f * 2**28 / mclk), 2**28 - 1)
    return reg * mclk / 2**28


def dds_fase_real(grados: float) -> float:
    return (round((grados % 360) * 4096 / 360) % 4096) * 360 / 4096


def dds_paso_amplitud(porcentaje: float) -> int:
    return int(round(min(max(porcentaje, 0.0), 100.0) / 100 * 255))


def dds_cal_selector(cal: list) -> list:
    """Calibración para el selector de Vpp: el 0 % se toma siempre como 0 V (lo que se mide
    ahí es ruido o un resto de señal), así el selector arranca en 0. La tabla guardada
    conserva lo medido."""
    if not cal:
        return []
    salida = [list(p) for p in cal if p[0] > 0]
    return [[0.0, 0.0, cal[0][2] if cal[0][0] == 0 else None]] + salida


def dds_porcentaje_cuantizado(porcentaje: float) -> float:
    """El % que de verdad queda: el potenciómetro tiene 256 pasos."""
    return dds_paso_amplitud(porcentaje) / 255 * 100


def dds_vpp(cal: list, porcentaje: float) -> float | None:
    """Vpp estimado para una amplitud en %, según los puntos medidos (None sin calibrar).
    Con un solo punto se supone proporcional (ganancia ∝ posición del potenciómetro)."""
    if not cal:
        return None
    if len(cal) == 1:
        p0, v0 = cal[0][0], cal[0][1]
        return v0 * porcentaje / p0 if p0 > 0 else None
    xs = [c[0] for c in cal]
    ys = [c[1] for c in cal]
    return float(np.interp(porcentaje, xs, ys))


def dds_vmedia(cal: list, porcentaje: float) -> float | None:
    pts = [(c[0], c[2]) for c in cal if c[2] is not None]
    if not pts:
        return None
    if len(pts) == 1:
        return pts[0][1]
    return float(np.interp(porcentaje, [p[0] for p in pts], [p[1] for p in pts]))


def dds_porcentaje_para_vpp(cal: list, vpp: float) -> float | None:
    """Inversa de dds_vpp (supone que el Vpp crece con el %). None si no hay calibración."""
    if not cal:
        return None
    if len(cal) == 1:
        p0, v0 = cal[0][0], cal[0][1]
        return min(max(vpp / v0 * p0, 0.0), 100.0) if v0 > 0 else None
    xs = [c[1] for c in cal]
    ys = [c[0] for c in cal]
    if any(b < a for a, b in zip(xs, xs[1:])):     # no creciente: no se puede invertir bien
        orden = sorted(zip(xs, ys))
        xs, ys = [o[0] for o in orden], [o[1] for o in orden]
    return float(np.interp(vpp, xs, ys))


def medir_seno(v: np.ndarray, fs: float, f: float) -> tuple[float, float]:
    """Vpp y tensión media de un seno de frecuencia conocida. El Vpp sale de un ajuste
    senoidal (no se engaña con el ruido ni con picos sueltos) y la media se toma sobre un
    número entero de períodos."""
    v = np.asarray(v, dtype=float)
    por_periodo = fs / f if f > 0 else len(v)
    n = int(len(v) // por_periodo * por_periodo) if por_periodo < len(v) else len(v)
    n = max(n, min(len(v), 16))
    fasor, _ = fasor_seno(v[:n], fs, f)
    return 2 * abs(fasor), float(np.mean(v[:n]))


def dds_mclk_corregido(mclk_actual: float, f_pedida: float, f_medida: float) -> float | None:
    """Reloj real del módulo a partir de una frecuencia pedida y la medida con el
    frecuencímetro. None si la medición no tiene sentido (sin señal o muy lejos)."""
    f_salida = dds_frecuencia_real(f_pedida, mclk_actual)   # lo que el firmware cree que sale
    if f_salida <= 0 or not (f_medida > 0):
        return None
    nuevo = mclk_actual * f_medida / f_salida
    if abs(nuevo / DDS_MCLK - 1) > 0.005:                   # más de 0,5 %: no es el AD9833
        return None
    return nuevo


def dds_texto_modulacion(c: ConfigDDS) -> str:
    m = c.modulacion
    if m == "Barrido":
        return f"DDSMOD {'LOG' if c.bar_log else 'LIN'} {c.bar_f1:.4f} {c.bar_f2:.4f} {c.bar_t:.4f}"
    if m == "FSK":
        return f"DDSMOD FSK {c.fsk_f2:.4f} {c.fsk_tasa:.4f}"
    if m == "PSK":
        return f"DDSMOD PSK {c.psk_fase2:.3f} {c.psk_tasa:.4f}"
    if m == "Ráfaga":
        return f"DDSMOD RAF {int(c.raf_ciclos)} {c.raf_periodo:.6f}"
    if m == "AM":
        return f"DDSMOD AM {c.am_prof / 100:.4f} {c.am_frec:.4f}"
    return "DDSMOD NO"


def dds_comandos(c: ConfigDDS, extendido: bool = True) -> list[str]:
    """Comandos para aplicar la configuración. Sin 'extendido' (firmware que solo conoce
    DDS y DDSA) no se mandan reloj, fase ni modulación, y la cuadrada f/2 va como cuadrada."""
    forma = DDS_FORMAS.index(c.forma) if c.forma in DDS_FORMAS else 0
    if not extendido:
        return [f"DDSA {dds_paso_amplitud(c.amplitud)}",
                f"DDS {c.frecuencia:.4f} {min(forma, 2)} {1 if c.habilitado else 0}"]
    return [f"DDSCLK {c.mclk:.1f}",
            f"DDSA {dds_paso_amplitud(c.amplitud)}",
            f"DDSF {c.fase:.3f}",
            f"DDS {c.frecuencia:.4f} {forma} {1 if c.habilitado else 0}",
            dds_texto_modulacion(c)]


def ruta_preferencias() -> Path:
    return carpeta_config() / "preferencias.json"


# Resoluciones que se ofrecen en Opciones gráficas (ancho, alto en píxeles reales).
# Funciona como en los juegos: con una resolución más chica que la de la pantalla todo se
# ve más grande, y con una más grande entra más en la misma pantalla.
RESOLUCIONES = [(1280, 720), (1366, 768), (1600, 900), (1920, 1080), (2560, 1440), (3840, 2160)]
RESOLUCION_AUTO = "auto"            # la misma que la pantalla (escala 1, la que elige Windows)
ESCALA_MIN, ESCALA_MAX = 0.5, 2.5


def texto_resolucion(res: tuple[int, int]) -> str:
    return f"{res[0]}×{res[1]}"


def leer_resolucion(texto) -> tuple[int, int] | None:
    """'1920x1080' (o '1920×1080') -> (1920, 1080). Cualquier otra cosa -> None (automática)."""
    try:
        a, b = str(texto).lower().replace("×", "x").split("x")
        res = (int(a), int(b))
    except (ValueError, AttributeError):
        return None
    return res if 320 <= res[0] <= 16384 and 240 <= res[1] <= 16384 else None


def escala_para(resolucion: tuple[int, int] | None, pantalla: tuple[int, int]) -> float:
    """Escala de la interfaz para que se vea como en una pantalla de 'resolucion' píxeles.
    None (automática) -> 1: tal cual la pantalla y el escalado del sistema."""
    if not resolucion or pantalla[0] <= 0 or pantalla[1] <= 0:
        return 1.0
    e = min(pantalla[0] / resolucion[0], pantalla[1] / resolucion[1])
    return round(min(max(e, ESCALA_MIN), ESCALA_MAX), 3)


def cargar_preferencias() -> dict:
    """{"placa": "F767", "preguntar": True, "resolucion": "auto" | "1920x1080"}"""
    pref = {"placa": PLACA_POR_DEFECTO, "preguntar": True, "resolucion": RESOLUCION_AUTO}
    try:
        d = json.loads(ruta_preferencias().read_text(encoding="utf-8"))
        if isinstance(d, dict):
            if d.get("placa") in PLACAS:
                pref["placa"] = d["placa"]
            pref["preguntar"] = bool(d.get("preguntar", True))
            res = leer_resolucion(d.get("resolucion"))
            if res:
                pref["resolucion"] = f"{res[0]}x{res[1]}"
    except (OSError, ValueError, TypeError):
        pass
    return pref


def resolucion_guardada() -> tuple[int, int] | None:
    """None = automática (la de la pantalla)."""
    return leer_resolucion(cargar_preferencias()["resolucion"])


def guardar_resolucion(res: tuple[int, int] | None):
    pref = cargar_preferencias()
    pref["resolucion"] = f"{res[0]}x{res[1]}" if res else RESOLUCION_AUTO
    guardar_preferencias(pref)


def guardar_preferencias(pref: dict):
    try:
        r = ruta_preferencias()
        r.parent.mkdir(parents=True, exist_ok=True)
        tmp = r.with_suffix(".json.tmp")
        tmp.write_text(json.dumps(pref, indent=2), encoding="utf-8")
        os.replace(tmp, r)
    except OSError:
        pass


@dataclass
class Config:
    puerto: str | None = None
    cal_salida: dict = field(default_factory=dict)     # "1:PLACA" -> Recta dict
    cal_entrada: dict = field(default_factory=dict)    # "1:ALTO"  -> Recta dict
    gen: dict = field(default_factory=dict)
    osc: dict = field(default_factory=dict)
    herramientas: dict = field(default_factory=dict)
    placa: str = PLACA_POR_DEFECTO      # a qué placa pertenece esta configuración

    def recta_salida(self, canal: int, modo: str) -> Recta:
        r = Recta.desde_dict(self.cal_salida.get(f"{canal}:{modo}", {}))
        return r or MODOS_SALIDA[modo].diseno

    def recta_entrada(self, canal: int, modo: str) -> Recta:
        r = Recta.desde_dict(self.cal_entrada.get(f"{canal}:{modo}", {}))
        return r or MODOS_ENTRADA[modo].diseno

    @staticmethod
    def cargar(placa: str = PLACA_POR_DEFECTO) -> "Config":
        ruta = ruta_config(placa)
        try:
            d = json.loads(ruta.read_text(encoding="utf-8"))
            if not isinstance(d, dict):
                raise ValueError("config.json no es un objeto JSON")
            c = Config(placa=placa)
            for k in asdict(c):
                if k in d and k != "placa":
                    setattr(c, k, d[k])
            return c
        except FileNotFoundError:
            return Config(placa=placa)
        except (OSError, ValueError, TypeError):
            # Archivo ilegible o cortado: se conserva una copia antes de que el
            # próximo guardado lo pise con los valores por defecto (las
            # calibraciones se hacen con multímetro y no conviene perderlas).
            try:
                ruta.replace(ruta.with_suffix(".json.corrupto"))
            except OSError:
                pass
            return Config(placa=placa)

    def guardar(self):
        try:
            r = ruta_config(self.placa)
            r.parent.mkdir(parents=True, exist_ok=True)
            tmp = r.with_suffix(".json.tmp")
            tmp.write_text(json.dumps(asdict(self), indent=2, ensure_ascii=False), encoding="utf-8")
            os.replace(tmp, r)      # atómico: nunca queda un config.json a medias
        except OSError:
            pass
