Fedemayol024/Proyecto-Gen-Osc-STM32/(commit log)

2026-10-22 Estado inicial: instrumento NUCLEO-F767ZI con firmware robustecido
    Osciloscopio, generador, Bode, frecuencimetro y PWM por USB CDC, con la app
    de PC en Python. Incluye las correcciones de robustez del firmware:
    - GTBL con timeout de 500 ms; esperas de DMA con tope
    - ISR del osciloscopio: un error de DMA ya no deja la captura trabada
    - disparo funcional con nivel menor que la histeresis
    - conversiones double->entero con saturacion en CAP/GSET
    - topes en modulacion AM/FM y en el tiempo muerto del PWM
    - aviso al host cuando se pierden respuestas (ERR tx_lleno, STAT?)
    Compila en CubeIDE sin advertencias; prueba en placa pendiente.
2026-10-22 App: quitar scripts parche ya integrados
    reparar.py, fix_cursores.py, aplicar_suavizado.py y aplicar_exportar_mediciones.py editaban tab_osciloscopio.py por reemplazo de texto. Sus cambios ya estan en el codigo actual (DialogoExportarImagen, suavizado, texto de cursores en el PNG), asi que no hacen falta y re-ejecutarlos era riesgoso. Siguen en el historial del primer commit.
2026-10-22 App: avisar cuando falla guardar CSV o PNG
    Los CSV del osciloscopio y de Bode se escribian sin try/except: si el archivo estaba en uso la accion fallaba sin avisar. QPixmap.save() devuelve False al fallar y se ignoraba, asi que la barra de estado decia 'Guardado' sin haber guardado. Ahora se captura OSError y se revisa el resultado de save(), mostrando el error en rojo.
2026-10-22 App: no perder las calibraciones si config.json se corrompe
    Si config.json estaba cortado o ilegible, Config.cargar() devolvia valores por defecto y el siguiente guardado pisaba el archivo, perdiendo las calibraciones hechas con multimetro. Ahora se guarda una copia como config.json.corrupto, y guardar() escribe a un temporal y lo reemplaza de forma atomica.
2026-10-22 App: validar el encabezado DATA y el estado de disparo
    Un encabezado DATA con n fuera de rango (0 o mayor que la ventana que informa el firmware) dejaba al lector esperando bytes que nunca llegan. medir() dividia por fs sin comprobar que fuera positivo. El estado de disparo desconocido ya no provoca KeyError en el dibujado.
2026-10-22 App: el suavizado ya no hunde los bordes de la captura
    np.convolve(mode='same') rellena con ceros: con el suavizado activo, una senal plana de 1 V aparecia en 0,5 V en el primer punto, y eso tambien contaminaba las mediciones. Se extrae suavizar() a modelo.py y se rellenan los bordes repitiendo el primer y el ultimo valor.
2026-10-22 Pruebas unitarias del modelo (24 casos, corren en Windows)
    Cubre Recta, leer_si/si, medir, espectro, suavizar, armar_tabla y Config (incluido archivo corrupto). Se ejecutan con: python -m unittest discover -s tests -v. Complementan prueba_app.py, que solo corre en Linux contra el Nucleo simulado.
2026-10-22 Osciloscopio: desplazamiento horizontal, lineas de 0 s y 0 V, CSV de lo que se ve
    - Desplazamiento horizontal de +-10 div (control 'Desplazar'): hasta 10 ms/div se capturan 3 pantallas (una extra a cada lado) y la app muestra una ventana movil. Mediciones, FFT, XY y CSV usan solo el tramo visible.
    - Referencias remarcadas: linea vertical clara de 0 s (instante del disparo, se mueve con el desplazamiento) y una linea de 0 V por canal con su color y etiqueta.
    - Exportar CSV: solo los canales visibles y solo el tramo en pantalla. Antes salian siempre los dos canales y, al cargarlo como forma arbitraria, el generador leia la ultima columna (CH2), que podia ser ruido.
    - Pruebas con la pestana lev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
2026-10-22 App: osciloscopio fluido (dibujo sin antialiasing, recorte y diezmado; desplazamiento hasta 2 ms/div)
    El dibujo de las curvas con antialiasing y trazo grueso tardaba 40-115 ms por
    cuadro y trababa la interfaz; ahora ~7 ms. Con bases de tiempo lentas, la
    captura de 3 pantallas para desplazar costaba 9 pantallas de tiempo (la placa
    busca el disparo en 2 capturas más); se limita a 2 ms/div.
    Claude-Session: https://claude.ai/code/session_01LtnoJossiyxpfkutaGvo95
2026-10-23 Modelo: algoritmo de tiempo equivalente (plegado por fase) con pruebas
    Reconstruye un periodo de una senal repetitiva a partir de una captura larga, ubicando cada muestra por su fase. Funciones nuevas en modelo.py: elegir_arr (reparte las fases; evita relaciones f/fs con pocas fases, como 3/2), refinar_frecuencia (afina una estimacion del frecuencimetro con la DFT), plegar_por_fase, alinear_a_flanco y calidad_plegado (distingue una senal periodica, ~1,3 mV, de una inestable, ~450 mV). 22 pruebas con senales simuladas: reconstruye 0,6 a 2,5 MHz con menos de 3 mV de error sobre 1 Vpp, donde el modo normal falla por mas de 300 mV. Todavia sin conectar a la interfaz.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
2026-10-23 Osciloscopio: perfil de adquisicion 'Tiempo equivalente' para senales repetitivas
    Selector Tiempo real / Tiempo equivalente en el grupo Horizontal. En tiempo equivalente la app mide la frecuencia con el frecuencimetro de la placa (FCNT sobre PA0), elige el ARR que reparte las fases (elegir_arr), pide una captura de 8192 muestras sin disparo, afina la frecuencia, pliega los dos canales con la misma fase y dibuja 256 puntos por periodo, con desplazamiento horizontal y mediciones. Si la senal no es repetitiva (residuo del pliegue mayor que 5 LSB + 2 % de Vpp) avisa y vuelve a medir la frecuencia; un canal que no repite a la frecuencia del de referencia se avisa y se dibuja plano. El tiempo real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
2026-10-23 LEEME: documentar el modo de adquisicion Tiempo equivalente
    Cuando usarlo, que conectar (la misma senal al canal y a PA0), sus limites (senales repetitivas y estables, sin eventos unicos, ancho de banda del frontal) y como probarlo con el PWM de la placa.
2026-10-23 Bode: capturas de ventana completa y promedio adaptativo con salida chica
    Cada punto usaba ~400 muestras. Ahora usa la ventana completa (8192) sin pasar
    de ~0,2 s por captura, y si la salida es de pocos escalones del ADC promedia
    H complejo de varias capturas hasta ~1 grado de incertidumbre de fase
    (maximo 16 capturas o 2 s por punto). RC simulado a 100 kHz (-56 dB):
    fase de +-7 a +-0,8 grados, ganancia de +-1,1 a +-0,13 dB.
2026-10-23 CSV con coma decimal para Excel en espanol
    Bode y osciloscopio exportaban con punto decimal: Excel en espanol lo toma como
    separador de miles (10.0001 -> 100001). Ahora escriben coma decimal con ';'.
    El lector de formas arbitrarias separaba por comas y habria partido esos
    numeros: ahora detecta el separador y acepta coma o punto decimal.
2026-10-27 Firmware: limpiar el código de LEDs (solo el azul LD2 como latido)
    Se quitan los toggles comentados de LD1/LD3 y ya no se reconfiguran PB0 y
    PB14 desde instrumento_iniciar(); quedan apagados como los deja CubeMX.
    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
2026-10-27 Soporte para NUCLEO-F429ZI: menú de placa en la app y firmware separado por placa
    Firmware
    - placa.h detecta el micro (STM32F767xx / STM32F429xx) y resuelve las
    diferencias: HAL, caché de datos (solo M7), código EXTSEL de TIM8_TRGO
    (0111 en F7, 1110 en F4), registro TIMPRE (DCKCFGR1 / DCKCFGR) y buffer
    del osciloscopio (16384 muestras en la F429: tiene 192 KB de SRAM).
    - ID? responde INSTR-F767 o INSTR-F429.
    - Carpetas: firmware/F767ZI (proyecto CubeIDE, movido) y firmware/F429ZI
    (archivos + guía para crear el proyecto a 168 MHz). Se quita la copia
    duplicada firmware/Core.
    - Compilado sin advertencias para las dos placas (F429: 135 KB de RAM).
    App
    - Diálogo inicial para elegi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
2026-10-27 App: pestaña Placa con capacidades, límites, pines y conexiones
    - Tabla de capacidades por placa (F767ZI / F429ZI) con la diferencia
    respecto de la otra, y valores medidos en vivo al conectar (INFO?).
    - Dibujo de la Nucleo-144 con los conectores ST Zio (UM1974) y la
    ubicación de cada pin usado; rótulos que no se superponen.
    - Diagramas de conexión: prueba rápida, Bode, señal externa,
    frecuencímetro y PWM.
    - Lista de limitaciones y cuidados.
    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
2026-10-27 Tiempo equivalente: diagrama de conexión, reloj correcto en la F429 y aviso de éxito
    - Pestaña Placa → Conexiones: nuevo esquema «Osciloscopio en Tiempo
    equivalente» (la misma señal a A0 y a D32, con la prueba del PWM).
    - El reloj de TIM8 para elegir el muestreo es 168 MHz en la F429 (antes
    se usaba el de la F767 hasta la primera captura).
    - La barra de estado confirma la señal reconstruida en lugar de quedar
    en «midiendo la frecuencia en PA0…».
    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
2026-10-27 Entradas solo por hardware: se quita el modo «Pin directo» del osciloscopio
    Las entradas (A0, A1, D32) se usan siempre a través de la etapa de entrada
    (Hoja 2) y la entrada protegida FREC (Hoja 3), para que nunca llegue al micro
    una tensión negativa o mayor a 3,3 V. Diagramas de conexión, límites, textos
    y pruebas actualizados.
    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
2026-10-27 Revert "Entradas solo por hardware: se quita el modo «Pin directo» del osciloscopio"
    This reverts commit 840778fd7a0d452c1c603180cdb95d4f93731c45.
2026-10-27 Se quita el modo «Tiempo equivalente» del osciloscopio
    Se vuelve a dejar «Pin directo» en las entradas (revert anterior) y se elimina
    el tiempo equivalente con su diagrama de conexión PWM → A0/D32, por el riesgo
    de esa conexión. También sale el consejo de probar con D6 → A0.
    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
2026-10-27 Hardware: diagrama de conexión del módulo AD9833 (SPI3 en CN8)
    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
2026-10-27 Osciloscopio: persistencia tipo fósforo, análisis de picos en la FFT y zoom de la interfaz
    - Persistencia 1 s / 2 s / 3 s / infinita: los trazos se acumulan en una imagen que se
    apaga con el tiempo; los transitorios quedan marcados. Se borra al cambiar escalas.
    - Ventana «Análisis de picos» (FFT): ventanas Blackman-Harris/Flat-top/Hann/Hamming/
    Rectangular, promediado de potencia, eliminación del piso de ruido (sustracción
    espectral sobre una mediana móvil), umbrales de detección, marcadores y línea de
    umbral arrastrable, tabla de picos con armónicos, THD, SNR, SINAD, ENOB y densidad
    de ruido. Exporta a CSV.
    - Zoom de toda la interfaz (80 % a 200 %): botones A−/A+, Ctr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
2026-10-27 Watchdog en el firmware (F767ZI y F429ZI) y reconexión automática en la app
    - Firmware: IWDG de 2 s pateado en el lazo principal, congelado durante la depuración.
    INFO? informa wdg_ms y la causa del último reinicio (watchdog, energía, botón,
    software). Compila sin advertencias para las dos placas.
    - App: si se pierde la conexión, busca el puerto durante 20 s y se reconecta sola,
    reenvía la configuración y avisa si el reinicio fue por el watchdog. La pestaña
    Placa muestra el watchdog y la causa del último reinicio.
    - LEEME: LED azul, watchdog y reconexión.
    Claude-Session: https://claude.ai/code/session_01LtnoJossiyxp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
2026-10-27 Versión 0.8.18 beta en la app y el firmware
    La app muestra la versión en el título y avisa si el firmware de la placa es de otra
    serie (MAYOR.MENOR distinto).
    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
2026-10-29 Notas de versión (CHANGELOG.md) reconstruidas desde el historial y regla para mantenerlas
    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
2026-10-29 F429ZI: la placa no respondía porque el proyecto no llamaba al instrumento
    Diagnóstico en el proyecto de CubeIDE de Jorge (f429zi/Proyect):
    - main.c no tenía #include "instrumento.h", instrumento_iniciar() ni
    instrumento_lazo(). Con --gc-sections, el instrumento entero quedaba
    fuera del binario.
    - CDC_Receive_FS (usbd_cdc_if.c) seguía con el código de CubeMX
    (SetRxBuffer + ReceivePacket) en lugar de instrumento_usb_rx().
    Resultado: Windows veía el puerto COM, pero ID?/INFO? no tenían respuesta.
    Arreglo aplicado en su PC (los dos archivos, dentro de los bloques USER
    CODE para que sobrevivan al regenerar con CubeMX), más el lineCoding de
    CDC_Control_FS. Compilado con arm-none-ea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
2026-10-29 Versión 0.8.19 beta: corrección de la conexión con la F429ZI
    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
2026-10-30 Single/Autoset ya no congelan el trazo; opciones gráficas (⚙) con resolución
    Single y Autoset congelaban el trazo en las dos placas (había que
    reconectar). Eran los únicos botones que mandaban una CAP con otra captura
    en curso; el firmware la abortaba a la mitad y el ADC dual quedaba en
    overrun sin volver a pedir DMA.
    - App: si hay una captura en camino, Single/Autoset esperan a que llegue
    y recién ahí piden la suya (accion_pendiente). STOP cancela un Single
    pendiente. Mensajes de «esperando el disparo» / «captura lista».
    - Firmware (F767ZI y F429ZI): osc_abortar() corta los pedidos de DMA del
    ADC, vacía datos, borra flags y reinicia ADC1/ADC2. Nuevo osc_vigilar()
    que re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
2026-10-30 AD9833: generador DDS externo (firmware para F767ZI/F429ZI y panel en la app)
    Firmware (ad9833.c/.h, igual en las dos placas):
    - SPI por software en PC10 CLK, PC12 DAT, PD2 FSY (AD9833) y PG2 CS
    (MCP41010). Reloj en reposo alto: el AD9833 lee en la bajada y el
    MCP41010 en la subida. Mismo código en F7 y F4.
    - DDS frec forma hab -> OK DDS frec_real (28 bits, MCLK 25 MHz, hasta
    12,5 MHz); DDSA paso -> OK DDSA (amplitud 0..255). INFO? dds_mclk=.
    - Arranca apagado (RESET + SLEEP). Palabras verificadas en la PC
    (1 kHz -> 0x69F1/0x4000; cuadrada 0x2028; triangular 0x2002).
    - Compila sin warnings para las dos placas.
    App: panel «Módulo AD9833» en Generador (forma, frecuencia, período,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
2026-10-30 Pestaña Placa: conexión del AD9833, sus pines marcados y sus capacidades
    Esquema nuevo en Conexiones («Módulo AD9833»): 3V3, GND, D45 CLK,
    D47 DAT, D48 FSY, D49 CS y la salida PGA hacia el circuito o la BNC,
    con la nota de alimentar a 3,3 V. En el dibujo de la placa se marcan
    los pines de CN8 que usa (color propio, distinto del CH2). Sección
    «Módulo AD9833 (opcional)» en Capacidades.
    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
2026-10-30 Pestaña Placa: cada cable de rótulo por su propio carril
    Antes todos los cables bajaban por la misma línea vertical junto a la
    placa y se pisaban (en CN8, con el AD9833, no se distinguía cuál iba a
    dónde). Ahora:
    - los de arriba usan los carriles de más afuera, así ninguno se cruza;
    - los pines de la columna de adentro salen primero al hueco entre filas
    y no pasan por encima del pin de al lado (GND y FSY de CN8 están en la
    misma fila).
    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
2026-10-31 Pestaña Placa: resaltar el cable al pasar el mouse por un rótulo o un pin
    Al pasar el mouse por un rótulo (o por el pin), ese cable se dibuja más
    grueso, con un halo y un anillo en el pin, el rótulo se ilumina y los
    demás se atenúan. Se dibuja último para que quede encima de todo. El
    cursor cambia a mano. Al salir del dibujo vuelve a la normalidad.
    Prueba nueva con el mouse simulado (rótulo y pin de CN8-12).
    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
2026-10-31 AD9833 ampliado: fase, f/2, modulaciones, calibración de amplitud y de reloj
    Firmware (ad9833.c, igual en F767ZI y F429ZI):
    - Fase (PHASE0/PHASE1, pasos de 0,088°) y cuadrada f/2.
    - Reloj real del módulo (DDSCLK, 20 a 30 MHz) para corregir el cristal.
    - Modulaciones avanzadas desde el lazo principal con el contador de ciclos
    (DWT): barrido LIN/LOG (cada 0,5 ms, fase continua), FSK y PSK con los
    dos registros del chip (hasta 5000 símbolos/s), ráfagas de N ciclos con
    RESET (arrancan en fase 0) y AM lenta con el potenciómetro (≤ 200 Hz).
    - Comandos DDSF, DDSCLK, DDSMOD; INFO? agrega dds_mod=1.
    - Verificado en la PC simulando pines y DWT: palabras SPI (fase 90° 0xC400,
    f/2 0x202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
2026-10-31 Calibración de amplitud del AD9833 paso a paso
    El diálogo ahora es un asistente: pone la salida en 0, 25, 50, 75 y
    100 % (seno de 1 kHz, sin modulación), muestra «Paso k de 5», y con
    «Continuar» (o Enter) guarda la medición y pasa al siguiente. Se puede
    volver, saltear un punto y corregir todo en el resumen final, donde
    también se conservan puntos medidos antes (p. ej. 80 %).
    Las tensiones se leen como las muestra un osciloscopio: «906,25mV»,
    «625,00 mV», «1,48 V», «1,48 Vpp», «1.48», «500 µV», «1.250,5 mV»;
    muestra cómo lo entendió y no deja avanzar si no lo entiende. La
    tensión media es opcional. Al terminar o cancelar, el AD9833 vuelve a
    la configuración que t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
2026-10-31 Calibración automática de la amplitud del AD9833 con el CH1 de la placa
    Otra opción dentro del asistente paso a paso («Medir automático con CH1»):
    con la salida PGA unida a A0, para cada punto (0/25/50/75/100 %) la app
    pone la amplitud, espera 450 ms, captura CH1 (8192 puntos a 200 kS/s,
    ~41 períodos de 1 kHz) y calcula:
    - Vpp con un ajuste senoidal a la frecuencia real del DDS (no lo engañan
    el ruido ni los picos sueltos) — modelo.medir_seno();
    - tensión media sobre un número entero de períodos.
    Avanza solo, avisa si se recortó en el ADC (sugiere la entrada ±10 V) o si
    a 100 % casi no hay señal, y deja el resumen para revisar y guardar.
    Pausa el osciloscopio mientras mide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
2026-10-31 AD9833: amplitud en Vpp con calibración y fase solo donde se nota
    - Con la amplitud calibrada, el control pasa a ser en Vpp (de 0 V a lo
    medido a 100 %) en lugar de %. Para el selector el 0 % cuenta como 0 V
    (dds_cal_selector); la tabla guarda lo medido. El valor queda en el
    paso más cercano del potenciómetro y se muestra el real (paso y %).
    - La fase se veía «sin efecto»: con una sola salida no hay contra qué
    compararla. Ahora aparece solo en PSK («Fase 1») y en ráfaga («Fase de
    arranque»: cada ráfaga arranca en ese ángulo), con la explicación.
    - Grados con coma decimal.
    Pruebas: 87 OK (nuevas: selector de Vpp con 0 % = 0 V y la tabla intacta,
    fase visible solo en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
2026-10-31 Bode con el AD9833 hasta 10 MHz (submuestreo y frecuencia estimada de los datos)
    Pestaña Bode: selector de Fuente (generador interno CH1 o Módulo AD9833).
    Con el AD9833:
    - hasta fs_max/2,5 mide directo (captura_bode de siempre); más arriba,
    submuestrea: fs_submuestreo() elige fs ≤ fs_max para que el alias quede
    cerca de fs/4. Como CH1 y CH2 se muestrean juntos, H = X2/X1 del alias
    conserva ganancia y fase; con alias negativo se conjuga.
    - estimar_frecuencia(): pico de FFT (Hann + interpolación) y sección áurea
    sobre la amplitud del ajuste senoidal: el reloj propio del módulo (ppm)
    no desfasa el ajuste. respuesta_bode() junta todo.
    - Usa la amplitud del panel AD9833, manda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
2026-10-31 Bode: ajuste de polos y ceros, tipo de respuesta y −3 dB desde la meseta correcta
    El «corte» se calculaba como 3 dB debajo del máximo. En un RL pasaaltos
    el máximo caía en la subida de 5 MHz (autorresonancia/acople) y el corte
    salía en 77 kHz sobre una meseta plana: no significaba nada.
    Ahora, al terminar el barrido:
    - mejor_modelo_bode(): ajusta H(s) = N/D de órdenes (0,1) (1,1) (0,2)
    (1,2) (2,2) con Sanathanan–Koerner y pesos robustos (IRLS sobre el
    error logarítmico complejo), descarta modelos inestables y elige el más
    simple que explica la curva;
    - analizar_modelo_bode(): agrupa polos/ceros (con Q), reconoce el piso de
    acople (ceros donde la curva ya está 37 dB aba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
2026-10-31 Bode: informe en PDF con polos y ceros, tabla de frecuencias y gráficos
    - informe_bode.py: informe A4 (QPdfWriter) con datos del ensayo, resumen,
    tabla numerada de cortes/polos/ceros (Q, s, región), H(s) ajustada,
    ganancia y fase medidas vs. modelo, constelación en el plano s (escala
    log-radial) con la misma numeración, error del ajuste y anexo de puntos.
    - Pestaña Bode: botón «Informe PDF…», diálogo de título y notas, datos del
    ensayo guardados al empezar el barrido (fuente, reloj del AD9833, rango,
    amplitud, entradas, duración).
    - modelo.py: singularidades_bode y ganancia_continua_bode.
    - Si no se puede escribir el archivo, avisa en vez de dar éxito falso.
    - 3 prueb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
2026-10-31 Informe PDF: nombre desde el título, borrar al barrer, puntos legibles; ajuste orden 3
    - El archivo del informe se llama como el título (saneado para Windows) y se
    guarda en la última carpeta usada (Documentos la primera vez).
    - Un barrido nuevo borra título y notas del informe anterior.
    - Gráficos del PDF: tamaño de punto según la densidad del barrido, descartados
    como aros rojos, modelo más fino, etiquetas verticales escalonadas.
    - Ajuste: órdenes (2,1) (3,2) (2,3) (3,3); el robusto descarta como mucho el
    20 %; polos inestables muy arriba del rango se reflejan; el corte de un
    pasaaltos se mide desde la primera meseta.
    - Pruebas: escalón con resonancia de protoboard, nombr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
2026-10-31 Bode: nombre del orden para todos los modelos («Modelo de 3 polos y 3 ceros»)
    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
2026-10-31 Versión 0.9.0 beta: módulo AD9833 y Bode hasta 10 MHz
    Versión menor (protocolo USB nuevo: DDS, DDSA, DDSF, DDSCLK, DDSMOD).
    - Notas de [Sin publicar] pasadas a [0.9.0 beta] · 2026-10-31, con lo ya
    probado en la NUCLEO-F767ZI y lo pendiente.
    - VERSION (app), INSTR_VERSION (F767ZI y F429ZI), Nucleo simulado y LEEME.
    - Firmware compilado para las dos placas sin warnings del código.
    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
